eliftplgl/ELE713-Two-Switch-Flyback/Flyback Design Tool.xlsx

 | Flyback Design Tool |  |  |  |  |  |  | COMPANSATOR DESIGN
 |  |  |  |  |  | ETD44 | ETD39
 |  | B_peak (selected) (T) | 0.3 | CORE | Ae (m^2) | 0.000173 | 0.000125 | Rout | 1.2
Given |  | J_rms (A/m^2) | 4000000 |  | g (mm) | 0.5 | 1 | Rcs | 0.004
Calculated |  | fill factor (selected) | 0.3 |  | Al (H/turns^2) | 4.38e-07 | 1.96e-07 | Acs | 3
 |  | fs (Hz) | 100000 |  | Aw (m^2) | 0.00027853 | 0.0002343 | tau_L | 1.572580645
 |  | n (efficiency) | 0.85 |  | Ve (m^3) | 1.78e-05 | 1.15e-05 | M | 0.6666666667
 |  | V_in_max (V) | 72 |  | N1 (calculated) | 9.282715253 | 13.87663127 | (1-Dmax)^2/tau_L | 0.2143920596
 |  | V_in_min (V) | 36 |  | N2 (calculated) | 4.641357627 | 6.938315634 | Go_1 | 200
 |  | V_out (V) | 12 |  | N1 (selected) | 10 | 14 | Go_2 | 0.3925069801
 |  | V_diode (V) | 1 |  | N2 (selected) | 5 | 7 | Go | 78.50139601
 |  | I_out (A) | 10 |  | B_peak (calculated) (T) | 0.2667802785 | 0.2469908088 | Go(dB) | 37.8975476
 |  | V_out + V_diode (V) | 13 |  | B_min (calculated) (T) | 0.1603799454 | 0.1585470317 | Cout(approx) | 0.001
 |  | P_out (W) | 120 |  | B_swing | 0.1064003332 | 0.08844377704 | Resr(approx) | 0.06
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
