eliftplgl/ELE713-Two-Switch-Flyback/componentList.xlsx

Part Number | Description | Quantity | MOQ | Digikey Link | Mouser Link | Türkiye Satıcı Link | Adet | Note/Comment
LM5576MHX/NOPB | Buck IC | 1 | 1 | https://ozdisan.com/entegre-devreler-icler/guc-entegreleri/dc-dc-voltaj-regulatorleri/LM5576MHXNOPB/585271
CL31B822KBCNNNC | Cap: 8.2 nF VDC: 50 V 1206 | 1 | 5 | https://ozdisan.com/pasif-komponentler/kapasitorler/smt-smd-ve-mlcc-kapasitorler/CL31B822KBCNNNC/28720
CL31B104KBCNNNC | Cap: 100 nF VDC: 50 V 1206 | 1 | 25 | https://ozdisan.com/pasif-komponentler/kapasitorler/smt-smd-ve-mlcc-kapasitorler/CL31B104KBCNNNC/5686
CL31C390JBCNNNC | Cap: 39 pF VDC: 50 V 1206 | 1 | 5 | https://ozdisan.com/pasif-komponentler/kapasitorler/smt-smd-ve-mlcc-kapasitorler/CL31C390JBCNNNC/523567
CL31B681KBCNNNC | Cap: 680 pF VDC: 50 V 1206 | 1 | 2 | https://ozdisan.com/pasif-komponentler/kapasitorler/smt-smd-ve-mlcc-kapasitorler/CL31B681KBCNNNC/523478
CC0805KPX7R9BB122 | Cap: 1.2 nF VDC: 50 V 0805 | 1 | 20 | https://ozdisan.com/pasif-komponentler/kapasitorler/smt-smd-ve-mlcc-kapasitorler/CC0805KPX7R9BB122/748786
CL31B223JBCNNNC | Cap: 22 nF VDC: 50 V 1206 | 1 | 5 | https://ozdisan.com/pasif-komponentler/kapasitorler/smt-smd-ve-mlcc-kapasitorler/CL31B223JBCNNNC/523388
1206S4F1021T5E | Res: 1.02 kΩ 1/4 W 1206 | 1 | 100 | https://ozdisan.com/pasif-komponentler/direncler/smt-smd-ve-cip-direncler/1206S4F1021T5E/505049
1206S4F4642T5E | Res: 46.4 kΩ 1/4 W 1206 | 1 | 100 | https://ozdisan.com/pasif-komponentler/direncler/smt-smd-ve-cip-direncler/1206S4F4642T5E/505175
1206S4F8871T5E | Res: 8.87 kΩ 1/4 W 1206 | 1 | 100 | https://ozdisan.com/pasif-komponentler/direncler/smt-smd-ve-cip-direncler/1206S4F8871T5E/505121
1206S4F2052T5E | Res: 20.5 kΩ 1/4 W 1206 | 1 | 100 | https://ozdisan.com/pasif-komponentler/direncler/smt-smd-ve-cip-direncler/1206S4F2052T5E/505145
V35PWM10HM3 | Schottky VRRM: 100 V Io: 35 A | 1 | 1 | https://ozdisan.com/guc-yari-iletkenleri/diyotlar-modul-diyotlar-ve-dogrultucular/schottky-diyotlar/V35PWM10HM3I-/743120
7447709680 | L: 68 µH DCR: 69 mΩ IDC: 3.2 A | 1 | 1 | https://ozdisan.com/pasif-komponentler/induktorler/sabit-induktorler/7447709680/514624
UC3845D8TR | Main Controller | 1 | 1 | https://ozdisan.com/integrated-circuits-ics/power-management-ics/dc-dc-switching-voltage-controllers/UC3845D8TR/445731
CC1206JRNPO9BN101 | Cap: 100 pF VDC: 50 V 1206 | 1 | 5 | https://ozdisan.com/passive-components/capacitors/smt-smd-and-mlcc-capacitors/CC1206JRNPO9BN101/750845
CL31B152KBCNNNC | Cap: 1.5 nF VDC: 50 V 1206 (CT) | 1 | 5 | https://ozdisan.com/passive-components/capacitors/smt-smd-and-mlcc-capacitors/CL31B152KBCNNNC/5693
CC1206KRX7R9BB682 | Cap: 6.8 nF VDC: 50 V 1206 | 1 | 5 | https://ozdisan.com/passive-components/capacitors/smt-smd-and-mlcc-capacitors/CC1206KRX7R9BB682/750181
C1206C103K5RACTU | Cap: 10 nF VDC: 50 V 1206 | 2 | 10 | https://ozdisan.com/passive-components/capacitors/smt-smd-and-mlcc-capacitors/C1206C103K5RACTU/704136
CL31B105KBHNNNE | Cap: 1 uF VDC: 50 V 1206 | 1 | 20 | https://ozdisan.com/passive-components/capacitors/smt-smd-and-mlcc-capacitors/CL31B105KBHNNNE/15253
CL31B475KBHNNNE | Cap: 4.7 uF VDC: 50 V 1206 | 1 | 5 | https://ozdisan.com/passive-components/capacitors/smt-smd-and-mlcc-capacitors/CL31B475KBHNNNE/369460
BVT-I-R004-1.0 | Res: 4 mΩ 6 W 2512 (Shunt) | 1 | 1 | https://ozdisan.com/passive-components/resistors/precision-power-and-shunt-resistors/BVT-I-R004-1-0/536254
1206S4F6800T5E | Res: 680 Ω 1/4 W 1206 1% | 1 | 100 | https://ozdisan.com/passive-components/resistors/smt-smd-and-chip-resistors/1206S4F6800T5E/345241
1206S4F1001T5E | Res: 1 kΩ 1/4 W 1206 1% | 2 | 100 | https://ozdisan.com/passive-components/resistors/smt-smd-and-chip-resistors/1206S4F1001T5E/31106
1206S4F2491T5E | Res: 2.49 kΩ 1/4 W 1206 1% | 1 | 100 | https://ozdisan.com/passive-components/resistors/smt-smd-and-chip-resistors/1206S4F2491T5E/505079
1206S4F4221T5E | Res: 4.22 kΩ 1/4 W 1206 1% (Rcsf) | 1 | 100 | https://ozdisan.com/passive-components/resistors/smt-smd-and-chip-resistors/1206S4F4221T5E/505095
0805S8F4991T5E | Res: 4.99 kΩ 1/8 W 0805 1% | 1 | 100 | https://ozdisan.com/passive-components/resistors/smt-smd-and-chip-resistors/1206S4F2491T5E/505079
1206S4F5761T5E | Res: 5.76 kΩ 1/4 W 1206 1% (RT) | 1 | 100 | https://ozdisan.com/passive-components/resistors/smt-smd-and-chip-resistors/1206S4F5761T5E/505106
2176093-3 | Res: 9.53 kΩ 1/4 W 1206 1% | 1 | 100 | https://ozdisan.com/passive-components/resistors/smt-smd-and-chip-resistors/1206S4F9531T5E/505123
CQ06S4F1002T5E | Res: 10 kΩ 1/4 W 1206 1% | 2 | 100 | https://ozdisan.com/passive-components/resistors/smt-smd-and-chip-resistors/CQ06S4F1002T5E/588060
1206S4F1822T5E | Res: 18.2 kΩ 1/4 W 1206 1% (Rp) | 1 | 100 | https://ozdisan.com/passive-components/resistors/smt-smd-and-chip-resistors/1206S4F1822T5E/505141
1206S4F3902T5E | Res: 39 kΩ 1/4 W 1206 1% | 1 | 100 | https://ozdisan.com/passive-components/resistors/smt-smd-and-chip-resistors/1206S4F3902T5E/35634
0805S8J0115T5E | Res: 1.1 MΩ 1/8 W 0805 5% | 1 | 100 | https://ozdisan.com/passive-components/resistors/smt-smd-and-chip-resistors/0805S8J0115T5E/335350
PZT2907AT1G | PNP | 1 | 2 | https://ozdisan.com/power-semiconductors/transistors/discrete-transistors/PZT2907AT1G/476538
PZT2222AT1G | NPN | 1 | 2 | https://ozdisan.com/power-semiconductors/transistors/discrete-transistors/PZT2222AT1G/476537
ISOM8110DFGR | Optocoupler | 1 |  | https://www.digikey.com/en/products/detail/texas-instruments/ISOM8110DFGR/22119473
BZT585B10T-7 | ZENER 10V 350 mW | 1 | 5 | https://ozdisan.com/power-semiconductors/diodes-diode-modules-and-rectifiers/zener-diodes/BZT585B10T-7/461982
TL431LIBQDBZRQ1 | TL431 | 1 | 1 | https://ozdisan.com/integrated-circuits-ics/power-management-ics/voltage-reference-ics/TL431LIBQDBZRQ1/1044375
R1S-1212-R | Isolated Supply 12-12 | 1 | 1 | https://ozdisan.com/power-supplies/converter-modules/dcdc-converters/R1S-1212-R/539069
DSSK28-006BS-TRL | Secondary Diode | 1 | 1 | https://ozdisan.com/power-semiconductors/diodes-diode-modules-and-rectifiers/schottky-diodes/DSSK28-006BS-TRL/642464
V35PWM10HM3/I | Primary Diodes | 2 | 2 | https://ozdisan.com/power-semiconductors/diodes-diode-modules-and-rectifiers/schottky-diodes/V35PWM10HM3I-/743120
FDD86110 | Primary MOSFETs | 2 | 2 | https://ozdisan.com/power-semiconductors/mosfets/discrete-mosfets/FDD86110/514788
2EDS8265HXUMA1 | Gate Driver | 1 | 1 | https://ozdisan.com/entegre-devreler-icler/guc-entegreleri/guc-surucu-entegreleri/2EDS8265HXUMA1/650229
BZX384-B15,115 | ZENER 15V 300 mW | 2 | 2 | https://ozdisan.com/guc-yari-iletkenleri/diyotlar-modul-diyotlar-ve-dogrultucular/zener-diyotlar/BZX384-B15115/538378
HP122WF100JT4E | Res: 10 Ω 2 W 2512 1% (Gate) | 2 | 5 | https://ozdisan.com/pasif-komponentler/direncler/smt-smd-ve-cip-direncler/HP122WF100JT4E/604578
HP06W2F1003T5E | Res: 100 kΩ 1/2 W 1206 1% | 2 | 50 | https://ozdisan.com/pasif-komponentler/direncler/smt-smd-ve-cip-direncler/HP06W2F1003T5E/604439
A768KS227M1VLAE024 | Cap Al: 47uF VDC: 50 V (1 mains_out, 1 buck_out) | 2 | 2 | https://ozdisan.com/pasif-komponentler/kapasitorler/aluminyum-kapasitorler/EEE-FT1H470AP/1044577
CL32B106KBJNNWE | Cap: 10 µF VDC: 50 V 1210 (2 iso_in, 3 gate driver, 2 buck_out, 3 mains_out) | 10 | 10 | https://ozdisan.com/pasif-komponentler/kapasitorler/smt-smd-ve-mlcc-kapasitorler/CL32B106KBJNNWE/523679
CL32B225KCJSNNE | Cap: 2.2 µF VDC: 100 V 1210 (3 buck_in, 3 mains_in) | 6 | 6 | https://ozdisan.com/pasif-komponentler/kapasitorler/smt-smd-ve-mlcc-kapasitorler/CL32B225KCJSNNE/483445
R82EC4100DQ70J | Cap Film: 1uF VDC: 100 V (2 mains_in, 2_mains_out) | 4 | 4 | https://ozdisan.com/pasif-komponentler/kapasitorler/film-kapasitorler/R82EC4100DQ70J/27926
