eliftplgl/ELE713-Two-Switch-Flyback/componentList_digikey.xlsx

Part Number | Description | Quantity | Digikey Link | Mouser Link | Türkiye Satıcı Link | Adet | Note/Comment
C0805C470J5GAC7800 | Cap: 47 pF VDC: 50 V 0805 | 1 | https://www.digikey.com/en/products/detail/kemet/C0805C470J5GAC7800/411116
CPF-A-0805B1M0E | Res: 1 MΩ 1/8 W 0805 0.1% | 1 | https://www.digikey.com/en/products/detail/te-connectivity-passive-product/CPF-A-0805B1M0E/5583876
C0805C222K5RACTU | Cap: 2.2 nF VDC: 50 V 0805 | 1 | https://www.digikey.com/en/products/detail/kemet/C0805C222K5RACTU/411150
CPF0805B100KE | Res: 100 kΩ 1/8 W 0805 0.1% | 1 | https://www.digikey.com/en/products/detail/te-connectivity-passive-product/CPF0805B100KE/2389788
LM5012DDAR | Buck IC | 1 | https://www.digikey.com/en/products/detail/texas-instruments/LM5012DDAR/16893898
CL32Y226KAVVPNE | Cap: 22 µF VDC: 25 V 1210 (DC-link) | 2 | https://www.digikey.com/en/products/detail/samsung-electro-mechanics/CL32Y226KAVVPNE/14565402
CL32Y475KCIVPJE | Cap: 4.7 µF VDC: 100 V 1210 (DC-link) | 4 | https://www.digikey.com/en/products/detail/samsung-electro-mechanics/CL32Y475KCIVPJE/14565405
7447709680 | L: 68 µH, 3.2 A R: 89mOhm | 1 | https://www.digikey.com/en/products/detail/würth-elektronik/7447709680/1638652
SDT5H100LP5-7 | Schottky VRRM: 100 V, Io = 5A | 1 | https://www.digikey.com/en/products/detail/diodes-incorporated/SDT5H100LP5-7/6702172
C0805C222K5RACTU | Cap: 2.2 nF VDC: 50 V 0805 | 1 | https://www.digikey.com/en/products/detail/kemet/C0805C222K5RACTU/411150
5-2176094-6 | Res: 453 kΩ 1/8 W 0805 0.1% | 1 | https://www.digikey.com/en/products/detail/te-connectivity-passive-product/5-2176094-6/4034266
RN73C2A49K9BTDF | Res: 49.9 kΩ 1/10 W 0805 0.1% | 1 | https://www.digikey.com/en/products/detail/te-connectivity-passive-product/RN73C2A49K9BTDF/2055754
CPF-A-0805B1M0E | Res: 1 MΩ 1/8 W 0805 0.1% | 1 | https://www.digikey.com/en/products/detail/te-connectivity-passive-product/CPF-A-0805B1M0E/5583876
750315126 | Flyback Transformer | 1 | https://www.digikey.com/en/products/detail/würth-elektronik/750315126/6173514
PMEG6030EP,115 | Schottky VRRM: 60 V, Io = 3A | 1 | https://www.digikey.com/en/products/detail/nexperia-usa-inc/PMEG6030EP-115/2296186
DFLS1150-7 | Schottky VRRM: 150 V, Io = 1A | 1 | https://www.digikey.com/en/products/detail/diodes-incorporated/DFLS1150-7/765613
CMZ5944B TR13 PBFREE | ZENER 62 V 1.5 W | 1 | https://www.digikey.com/en/products/detail/central-semiconductor-corp/CMZ5944B-TR13-PBFREE/5325075
CL32Y106KCVZNWE | Cap: 10 µF VDC: 100 V 1210 (DC-link) | 2 | https://www.digikey.com/en/products/detail/samsung-electro-mechanics/CL32Y106KCVZNWE/15992073
CL32Y226KAVVPNE | Cap: 22 µF VDC: 25 V 1210 (DC-link) | 3 | https://www.digikey.com/en/products/detail/samsung-electro-mechanics/CL32Y226KAVVPNE/14565402
CL32Y475KCIVPJE | Cap: 4.7 µF VDC: 100 V 1210 (DC-link) | 3 | https://www.digikey.com/en/products/detail/samsung-electro-mechanics/CL32Y475KCIVPJE/14565405
9-2176093-0 | Res: 88.7 kΩ 1/8 W 0805 0.1% | 1 | https://www.digikey.com/en/products/detail/te-connectivity-passive-product/9-2176093-0/4034198
CPF0805B10KE | Res: 10 kΩ 1/8 W 0805 0.1% | 1 | https://www.digikey.com/en/products/detail/te-connectivity-passive-product/CPF0805B10KE/2389790
2-2176094-9 | Res: 237 kΩ 1/8 W 0805 0.1% | 1 | https://www.digikey.com/en/products/detail/te-connectivity-passive-product/2-2176094-9/4034239
3522100RJT | Res: 100 Ω 3 W 2512 (Snubber) | 1 | https://www.digikey.com/en/products/detail/te-connectivity-passive-product/3522100RJT/5244970
R76QD0220SE00J | Cap: 220 pF 1 kV (Snubber) | 1 | https://www.digikey.com/en/products/detail/kemet/R76QD0220SE00J/2704673
LT8304IS8E#PBF | Flyback Controller | 1 | https://www.digikey.com/en/products/detail/analog-devices-inc/LT8304IS8E-PBF/6025915
CL21A475KAQNNNE | Cap: 4.7 uF VDC: 25 V 0805 | 1 | https://www.digikey.com/en/products/detail/samsung-electro-mechanics/CL21A475KAQNNNE/3886902
CPF0805B10KE | Res: 10 kΩ 1/8 W 0805 0.1% | 2 | https://www.digikey.com/en/products/detail/te-connectivity-passive-product/CPF0805B10KE/2389790
PMBT2907A-QR | PNP | 1 | https://www.digikey.com/en/products/detail/nexperia-usa-inc/PMBT2907A-QR/18634502
PMBT2222A-QR | NPN | 1 | https://www.digikey.com/en/products/detail/nexperia-usa-inc/PMBT2222A-QR/18634518
C0805C682K5RAC7800 | Cap: 6.8 nF VDC: 50 V 0805 | 1 | https://www.digikey.com/en/products/detail/kemet/C0805C682K5RAC7800/411156
C0805C103K5RACTU | Cap: 10 nF VDC: 50 V 0805 | 2 | https://www.digikey.com/en/products/detail/kemet/C0805C103K5RACTU/411157
CPF0805B1M1E1 | Res: 1.1 MΩ 1/10 W 0805 0.1% | 1 | https://www.digikey.com/en/products/detail/te-connectivity-passive-product/CPF0805B1M1E1/2731308
CPF-A-0805B12KE | Res: 12 kΩ 1/10 W 0805 0.1% | 1 | https://www.digikey.com/en/products/detail/te-connectivity-passive-product/CPF-A-0805B12KE/5583862
C0805C471K5RAC7800 | Cap: 470 pF VDC: 50 V 0805 | 1 | https://www.digikey.com/en/products/detail/kemet/C0805C471K5RAC7800/411141
C0805C101J5GAC7800 | Cap: 100 pF VDC: 50 V 0805 | 1 | https://www.digikey.com/en/products/detail/kemet/C0805C101J5GAC7800/411121
C0805C105K3RAC7210 | Cap: 1 uF VDC: 25 V 0805 | 1 | https://www.digikey.com/en/products/detail/kemet/C0805C105K3RAC7210/12701357
6-2176092-8 | Res: 3.83 kΩ 1/4 W 0805 0.1% | 1 | https://www.digikey.com/en/products/detail/te-connectivity-passive-product/6-2176092-8/4034067
2-2176093-4 | Res: 16.5 kΩ 1/4 W 0805 0.1% | 1 | https://www.digikey.com/en/products/detail/te-connectivity-passive-product/2-2176093-4/4034128
CPF0805B4K99E1 | Res: 4.99 kΩ 1/10 W 0805 0.1% | 1 | https://www.digikey.com/en/products/detail/te-connectivity-passive-product/CPF0805B4K99E1/2383373
CPF0805B1K0E | Res: 1 kΩ 1/10 W 0805 0.1% | 2 | https://www.digikey.com/en/products/detail/te-connectivity-passive-product/CPF0805B1K0E/2390399
CPF-A-0805B680RE | Res: 680 Ω 1/10 W 0805 0.1% | 1 | https://www.digikey.com/en/products/detail/te-connectivity-passive-product/CPF-A-0805B680RE/5583918
CPF-A-0805B39KE | Res: 39 kΩ 1/10 W 0805 0.1% | 1 | https://www.digikey.com/en/products/detail/te-connectivity-passive-product/CPF-A-0805B39KE/5583901
2176093-3 | Res: 9.53 kΩ 1/10 W 0805 0.1% | 1 | https://www.digikey.com/en/products/detail/te-connectivity-passive-product/2176093-3/4034105
5-2176092-1 | Res: 2.49 kΩ 1/10 W 0805 0.1% | 1 | https://www.digikey.com/en/products/detail/te-connectivity-passive-product/5-2176092-1/4034049
BZX84-A10,215 | ZENER 10V 250 mW | 1 | https://www.digikey.com/en/products/detail/nexperia-usa-inc/BZX84-A10-215/2119643
TL431LIBQDBZR | TL431 | 1 | https://www.digikey.com/en/products/detail/texas-instruments/TL431LIBQDBZR/9861503
UCC28C55DGKR | Main Controller | 1 | https://www.digikey.com/en/products/detail/texas-instruments/UCC28C55DGKR/18111331
TLRP3A30CR004FTE | Res: 4 mΩ 3 W 2512 (Shunt) | 1 | https://www.digikey.com/en/products/detail/te-connectivity-passive-product/TLRP3A30CR004FTE/14652341
ISOM8110DFGR | Optocoupler | 1 | https://www.digikey.com/en/products/detail/texas-instruments/ISOM8110DFGR/22119473
V35PWL63-M3/I | Secondary Diode | 1 | https://www.digikey.com/en/products/detail/vishay-general-semiconductor-diodes-division/V35PWL63-M3-I/16683171
SDT5H100LP5-7 | Primary Diodes | 2 | https://www.digikey.com/en/products/detail/diodes-incorporated/SDT5H100LP5-7/6702172
BSC096N10LS5ATMA1 | Primary MOSFETs | 2 | https://www.digikey.com/en/products/detail/infineon-technologies/BSC096N10LS5ATMA1/11500405
2EDB8259FXUMA1 | Gate Driver | 1 | https://www.digikey.com/en/products/detail/infineon-technologies/2EDB8259FXUMA1/16669035
BZT52H-A18-QX | ZENER 18V 250 mW | 2 | https://www.digikey.com/en/products/detail/nexperia-usa-inc/BZT52H-A18-QX/17295694
RQ73C2B10RBTD | Res: 10 Ω 1 W 1206 0.1% | 2 | https://www.digikey.com/en/products/detail/te-connectivity-passive-product/RQ73C2B10RBTD/9479828
CPF0805B100KE | Res: 100 kΩ 1/8 W 0805 0.1% | 2 | https://www.digikey.com/en/products/detail/te-connectivity-passive-product/CPF0805B100KE/2389788
SC-18-10J | Input Choke | 2 | https://www.digikey.com/en/products/detail/kemet/SC-18-10J/10441828
A759MS226M2AAAE045 | Input AlPo Cap | 2 | https://www.digikey.com/en/products/detail/kemet/A759MS226M2AAAE045/6196528
R60IN43305030J | Input Film Cap | 2 | https://www.digikey.com/en/products/detail/kemet/R60IN43305030J/12178362
CL32Y475KCIVPJE | Cap: 4.7 µF VDC: 100 V 1210 (DC-link) | 4 | https://www.digikey.com/en/products/detail/samsung-electro-mechanics/CL32Y475KCIVPJE/14565405
A768KS227M1VLAE024 | Output AlPo Cap | 2 | https://www.digikey.com/en/products/detail/kemet/A768KS227M1VLAE024/12704040
R66DD4220AA6AJ | Output Film Cap | 2 | https://www.digikey.com/en/products/detail/kemet/R66DD4220AA6AJ/13176308
CL32Y226KAVVPNE | Cap: 22 µF VDC: 25 V 1210 (DC-link) | 4 | https://www.digikey.com/en/products/detail/samsung-electro-mechanics/CL32Y226KAVVPNE/14565402
