eliftplgl/ELE713-Two-Switch-Flyback/PCB/ele713_ozdisan/ele713_ozdisan/KiCad Library/LM5576MHX_NOPB.step

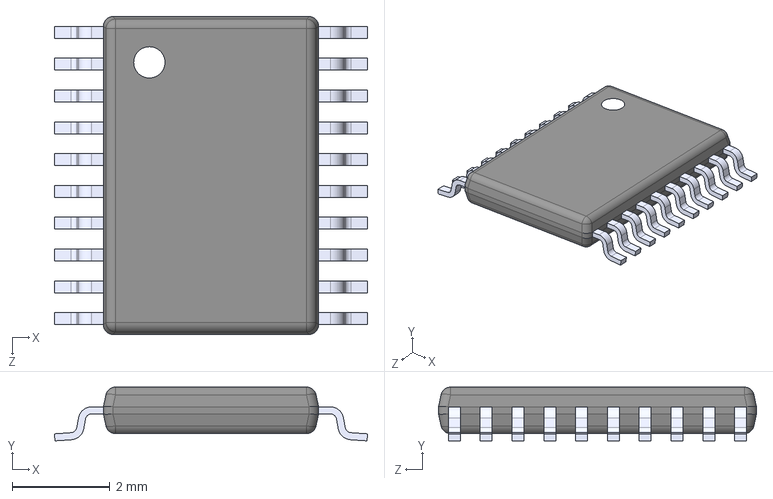
[picture p11: CAD file, 2024-12-31]
PCB/ele713_ozdisan/ele713_ozdisan/KiCad Library/LM5576MHX_NOPB.step
6.40 x 1.10 x 6.50 mm
