eliftplgl/ELE713-Two-Switch-Flyback/PCB/ele713_ozdisan/ele713_ozdisan/KiCad Library/UC3845AD8G4.step

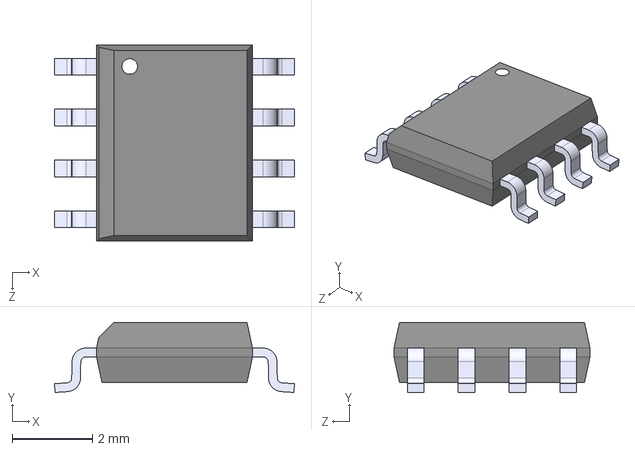
[picture p12: CAD file, 2024-12-31]
PCB/ele713_ozdisan/ele713_ozdisan/KiCad Library/UC3845AD8G4.step
6.00 x 1.75 x 4.90 mm
