eliftplgl/ELE713-Two-Switch-Flyback/PCB/ele713_ozdisan/ele713_ozdisan/KiCad Library/R1S-1212-R.step

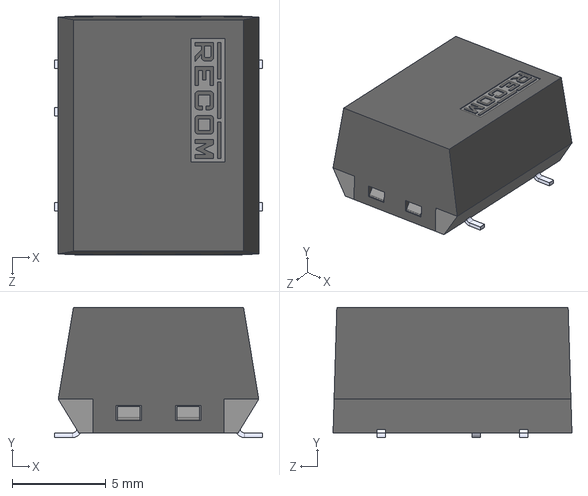
[picture p13: CAD file, 2024-12-31]
PCB/ele713_ozdisan/ele713_ozdisan/KiCad Library/R1S-1212-R.step
11.1 x 6.95 x 12.8 mm
