eliftplgl/ELE713-Two-Switch-Flyback/PCB/ele713_ozdisan/ele713_ozdisan/KiCad Library/WE-PD_1210.step

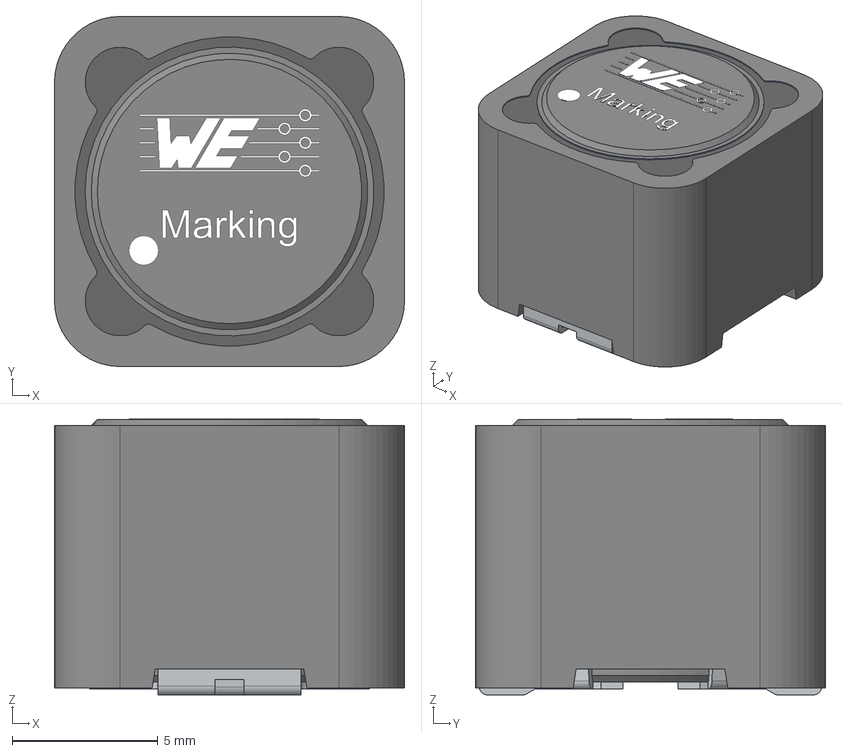
[picture p14: CAD file, 2024-12-31]
PCB/ele713_ozdisan/ele713_ozdisan/KiCad Library/WE-PD_1210.step
12.0 x 12.0 x 9.46 mm
Core
ShieldRing
Glue
Leadframe
