eliftplgl/ELE713-Two-Switch-Flyback/PCB/ele713_ozdisan/ele713_ozdisan/KiCad Library/R82EC4100DQ70J.stp

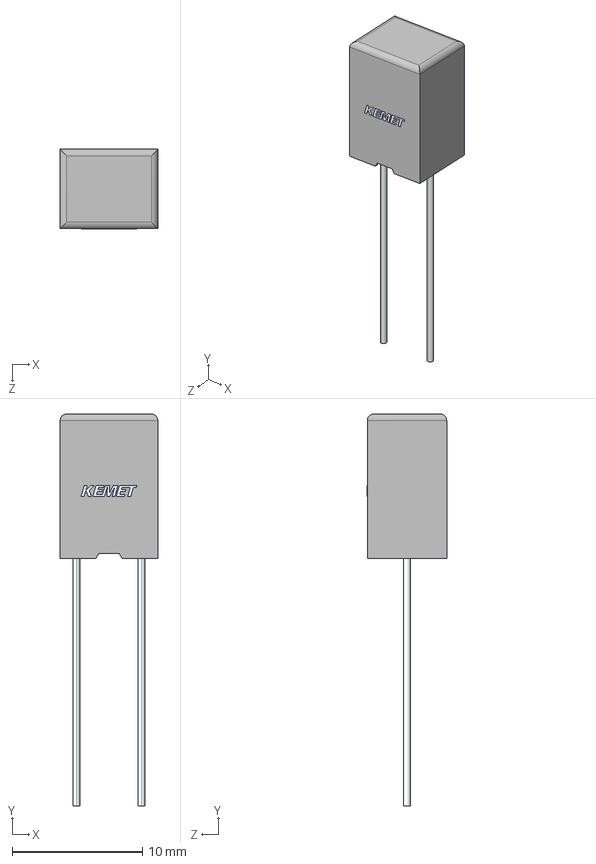
[picture p15: CAD file, 2024-12-31]
PCB/ele713_ozdisan/ele713_ozdisan/KiCad Library/R82EC4100DQ70J.stp
7.50 x 30.1 x 6.10 mm
