eliftplgl/ELE713-Two-Switch-Flyback/PCB/ele713_ozdisan/ele713_ozdisan/KiCad Library/BZT585B10T-7.stp

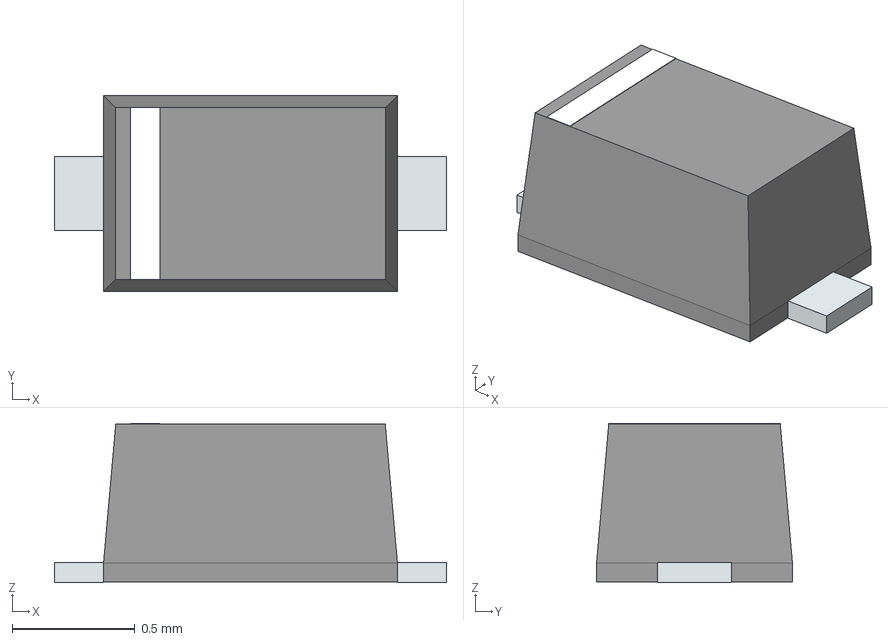
[picture p16: CAD file, 2024-12-31]
PCB/ele713_ozdisan/ele713_ozdisan/KiCad Library/BZT585B10T-7.stp
1.60 x 0.8 x 0.65 mm
PinKIdent
PinK
PinA
