eliftplgl/ELE713-Two-Switch-Flyback/PCB/ele713_ozdisan/ele713_ozdisan/KiCad Library/R76QD0220SE00J.stp

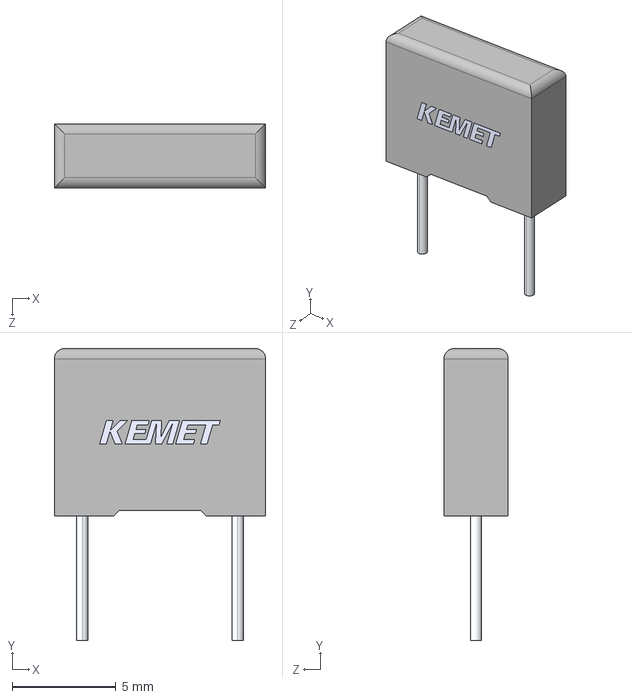
[picture p17: CAD file, 2024-12-11]
PCB/ele713_ozdisan/ele713_ozdisan/KiCad Library/R76QD0220SE00J.stp
10.2 x 14.1 x 3.10 mm
