eliftplgl/ELE713-Two-Switch-Flyback/PCB/ele713_ozdisan/ele713_ozdisan/KiCad Library/PowerDI5.stp

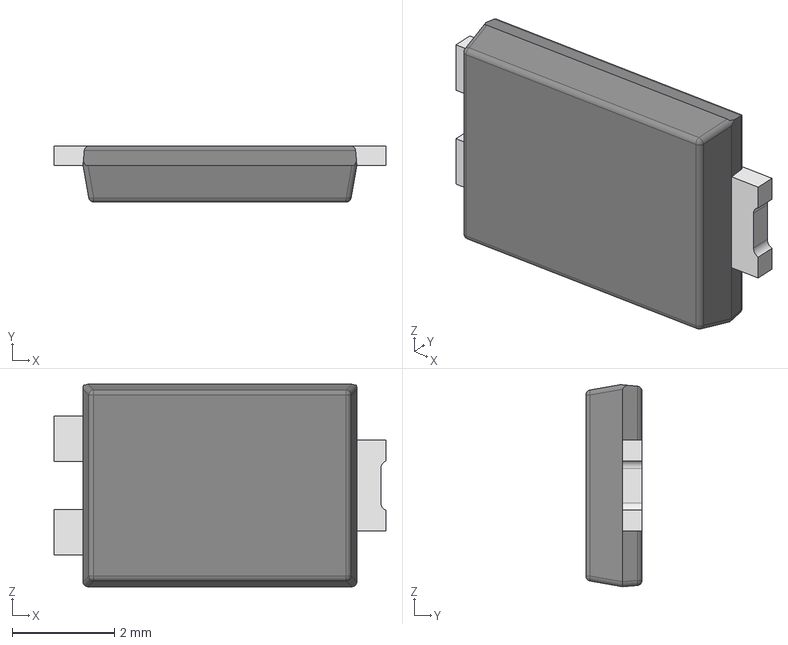
[picture p18: CAD file, 2024-12-11]
PCB/ele713_ozdisan/ele713_ozdisan/KiCad Library/PowerDI5.stp
6.51 x 1.10 x 3.97 mm
PD-5 compound
PD-5 LF_0
PD-5 LF
