eliftplgl/ELE713-Two-Switch-Flyback/PCB/ele713_ozdisan/ele713_ozdisan/KiCad Library/A768KS227M1VLAE024.stp

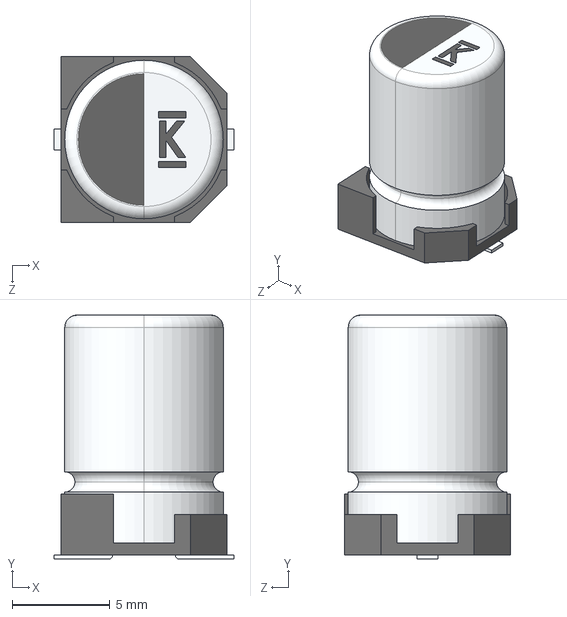
[picture p19: CAD file, 2024-12-11]
PCB/ele713_ozdisan/ele713_ozdisan/KiCad Library/A768KS227M1VLAE024.stp
9.20 x 12.5 x 8.50 mm
