eliftplgl/ELE713-Two-Switch-Flyback/PCB/ele713_ozdisan/ele713_ozdisan/KiCad Library/WE-FLYLT_EP13_L13.46W17.75H12.70.STEP

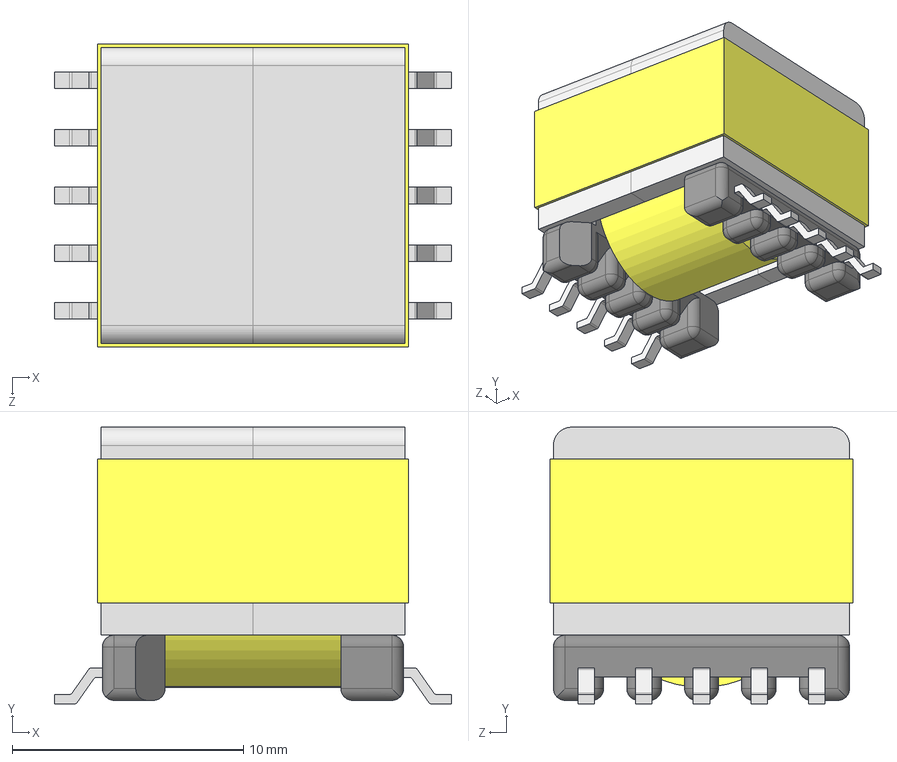
[picture p20: CAD file, 2024-12-11]
PCB/ele713_ozdisan/ele713_ozdisan/KiCad Library/WE-FLYLT_EP13_L13.46W17.75H12.70.STEP
17.2 x 12.0 x 13.1 mm
070-5465_6A
070-5465_coil
150-2363_6A x 2
