eliftplgl/ELE713-Two-Switch-Flyback/PCB/ele713_ozdisan/ele713_ozdisan/KiCad Library/F861KM473M310A.stp

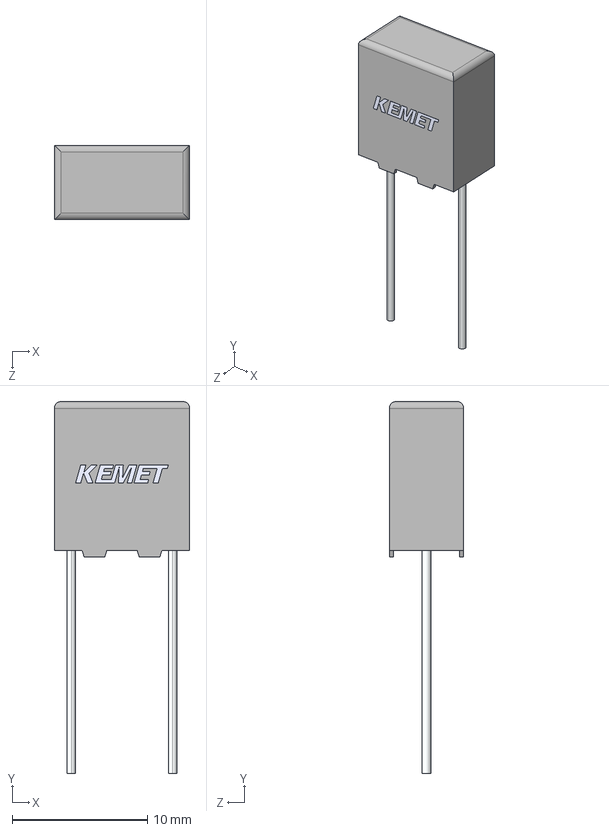
[picture p21: CAD file, 2024-12-11]
PCB/ele713_ozdisan/ele713_ozdisan/KiCad Library/F861KM473M310A.stp
10.0 x 27.5 x 5.50 mm
