eliftplgl/ELE713-Two-Switch-Flyback/PCB/ele713_ozdisan/ele713_ozdisan/KiCad Library/R46KN410050N1K.stp

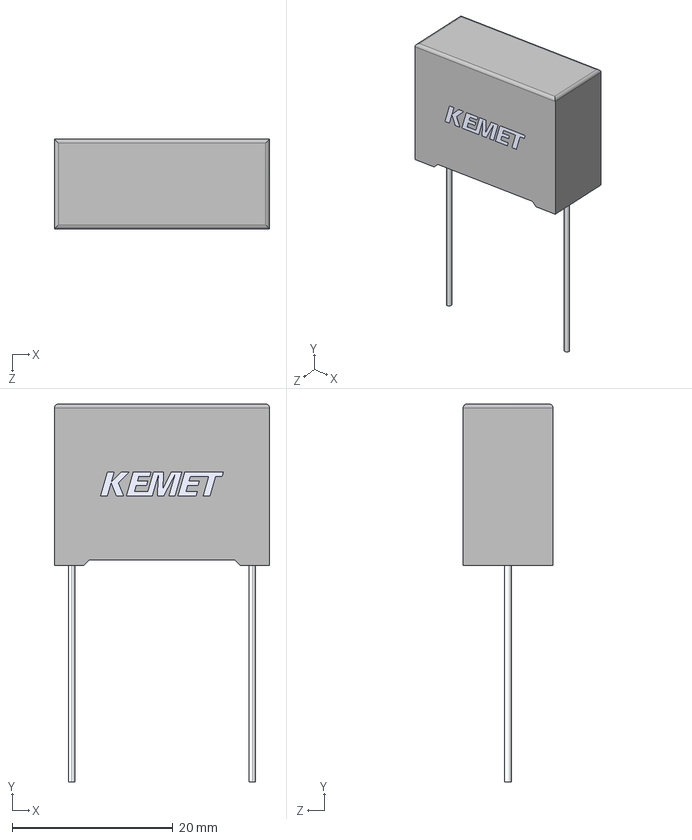
[picture p22: CAD file, 2024-12-11]
PCB/ele713_ozdisan/ele713_ozdisan/KiCad Library/R46KN410050N1K.stp
26.8 x 47.1 x 11.2 mm
