eliftplgl/ELE713-Two-Switch-Flyback/PCB/ele713_ozdisan/ele713_ozdisan/KiCad Library/DFG0004A.stp

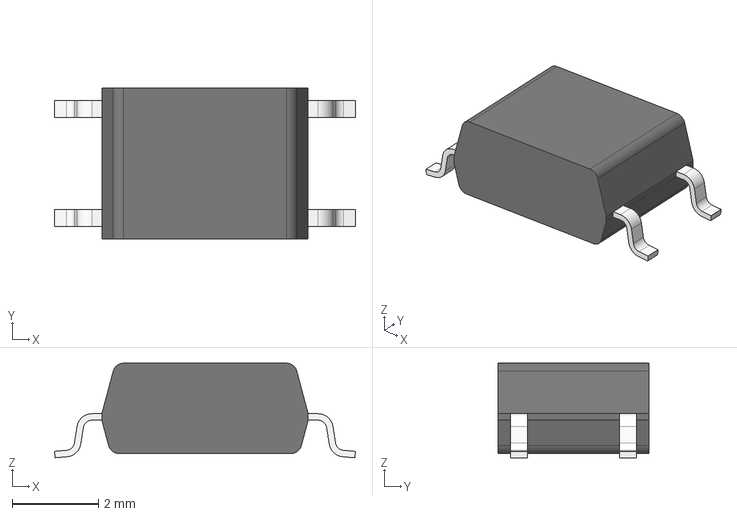
[picture p23: CAD file, 2024-12-11]
PCB/ele713_ozdisan/ele713_ozdisan/KiCad Library/DFG0004A.stp
7.00 x 3.51 x 2.20 mm
DFG0004A_MOLD
DFG0004A_PIN x 4
