eliftplgl/ELE713-Two-Switch-Flyback/PCB/ele713_ozdisan/ele713_ozdisan/KiCad Library/SC-18-10J.stp

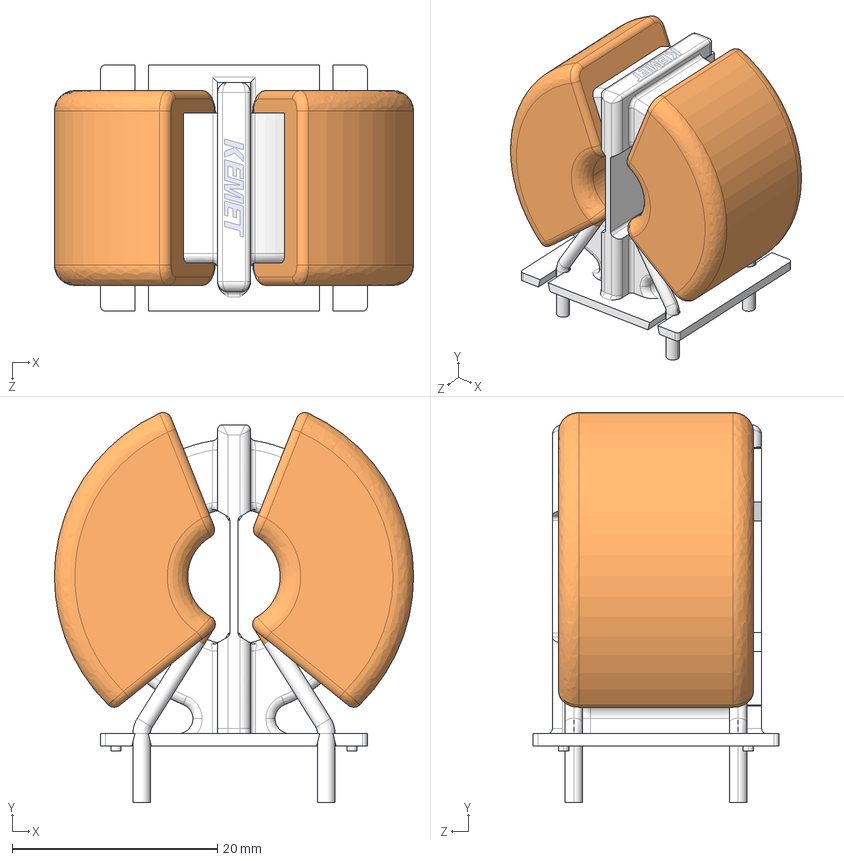
[picture p24: CAD file, 2024-12-11]
PCB/ele713_ozdisan/ele713_ozdisan/KiCad Library/SC-18-10J.stp
35.0 x 38.0 x 24.0 mm
