eliftplgl/ELE713-Two-Switch-Flyback/PCB/ele713_ozdisan/ele713_ozdisan/KiCad Library/c61036-a0104-b201_etd39_sw.step

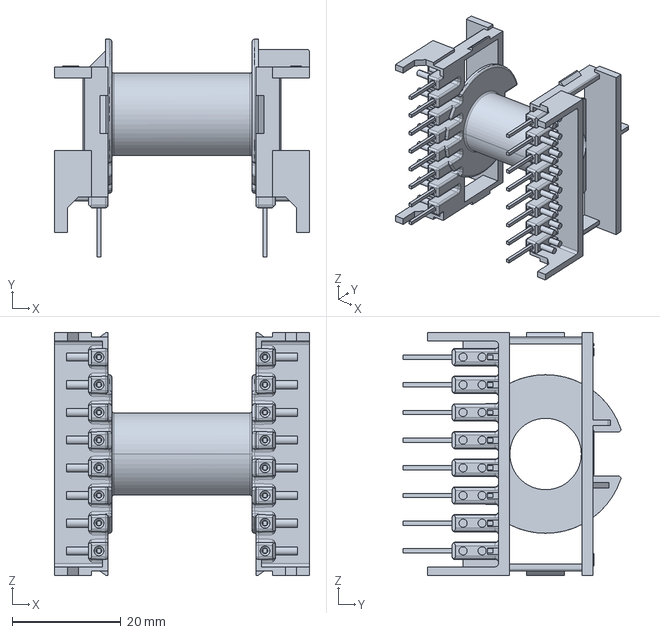
[picture p25: CAD file, 2024-12-11]
PCB/ele713_ozdisan/ele713_ozdisan/KiCad Library/c61036-a0104-b201_etd39_sw.step
46.8 x 40.0 x 44.6 mm
