eliftplgl/ELE713-Two-Switch-Flyback/ltspice flyback sim/Draft1.asc

Cout: cap; 100µ
D1: schottky; RBQ30NS100A
D2: schottky; RBQ30NS100A
D3: schottky; RBQ30NS100A
L1: ind2; 37.7e-6
L2: ind2; 9.43548E-06
M1: nmos; BSC100N10NSF
M2: nmos; BSC100N10NSF
Rload: res; 1.2
V1: voltage; PULSE(-20 10 0 1e-9 1e-9 0.42e-5 1e-5)
V2: voltage; PULSE(-20 10 0 1e-9 1e-9 0.42e-5 1e-5)
Vin: voltage; 36
Named nets: 0, PWM, PWM_high, PWM_low
.tran 1.5e-3
K L1 L2 1
