eliftplgl/ELE713-Two-Switch-Flyback/PCB/ele713_ozdisan/ele713_ozdisan/ele713_ozdisan.kicad_pcb

## KiCad design PCB/ele713_ozdisan/ele713_ozdisan/ele713_ozdisan.kicad_pcb (2024-12-31, an earlier design)

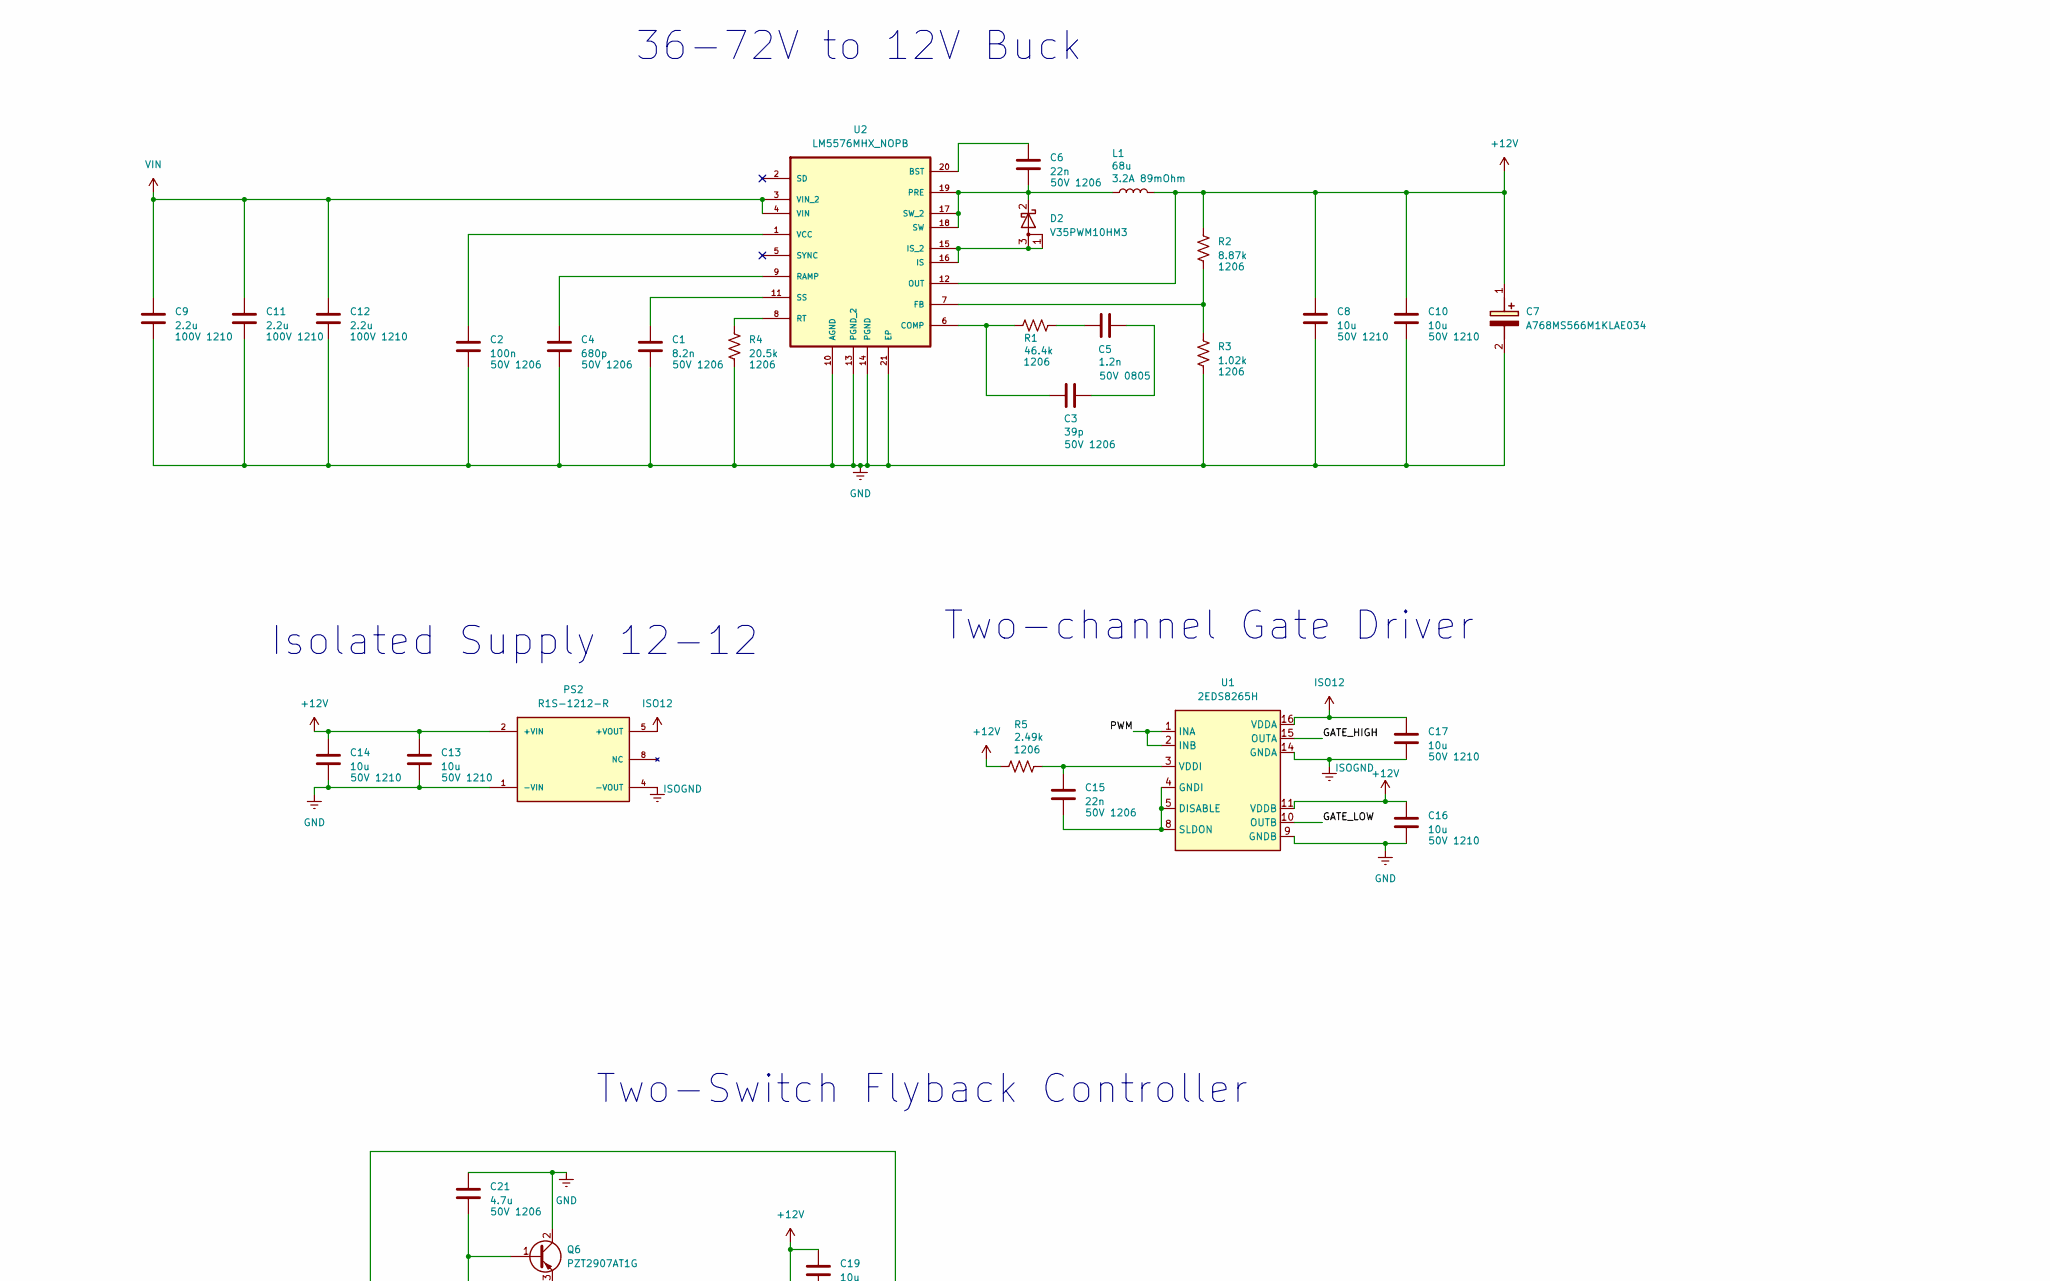
[picture p26: schematic ele713_ozdisan.kicad_sch, part in row 1, column 1]

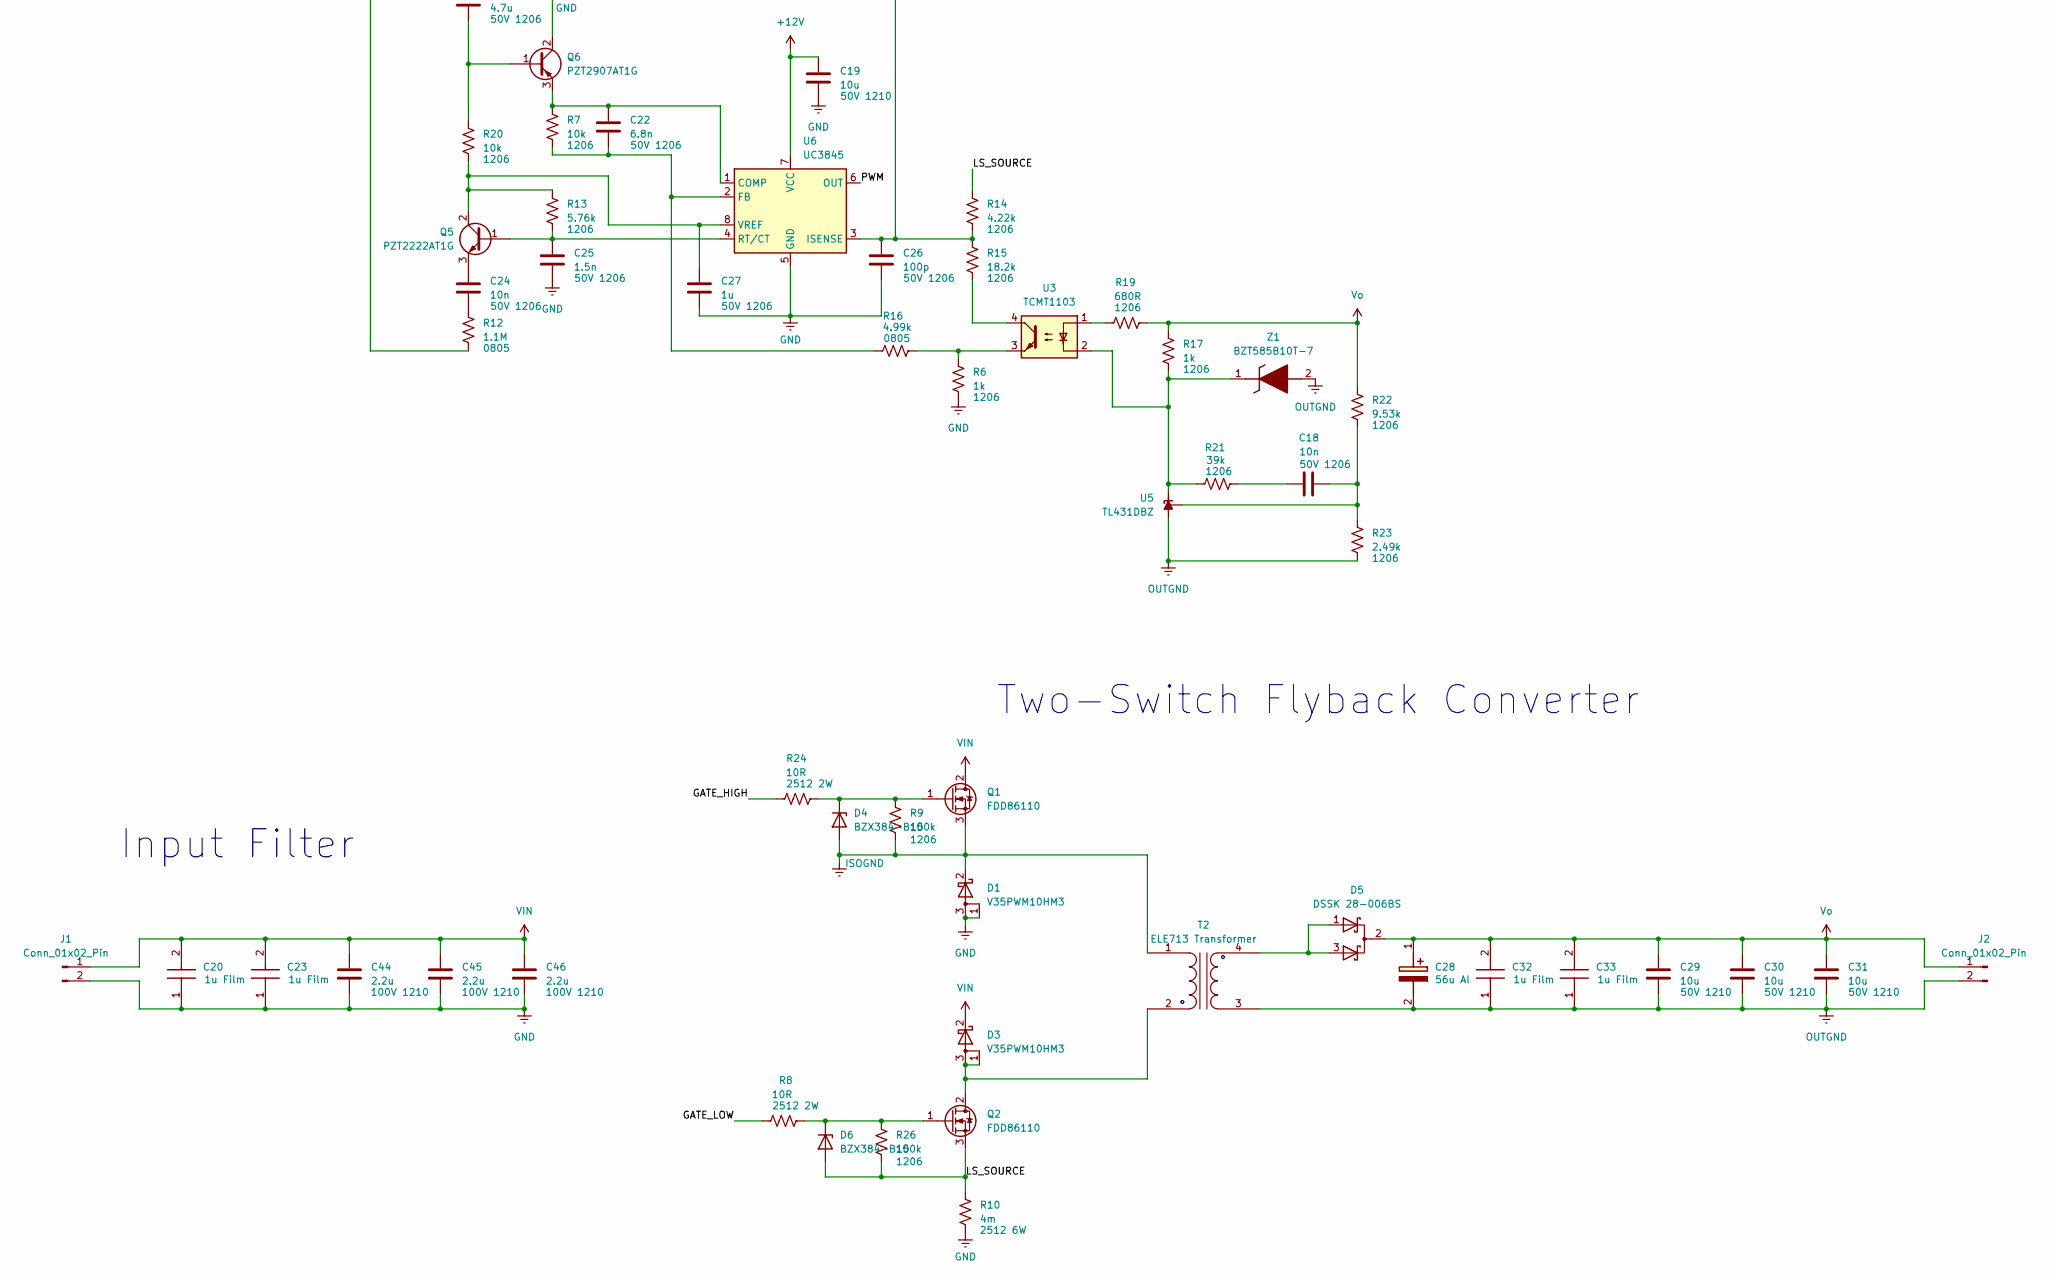
[picture p27: schematic ele713_ozdisan.kicad_sch, part in row 2, column 1]

Parts:
C1: 8.2n; C_1206_3216Metric_Pad1.33x1.80mm_HandSolder
C2: 100n; C_1206_3216Metric_Pad1.33x1.80mm_HandSolder
C3: 39p; C_1206_3216Metric_Pad1.33x1.80mm_HandSolder
C4: 680p; C_1206_3216Metric_Pad1.33x1.80mm_HandSolder
C5: 1.2n; C_0805_2012Metric_Pad1.18x1.45mm_HandSolder
C6, C15: 22n; C_1206_3216Metric_Pad1.33x1.80mm_HandSolder
C7, C28: A768MS566M1KLAE034; CAPAE1030X1270N; Manufacturer_Part_Number A768MS566M1KLAE034; Mouser Part Number 80-A768MS566M1KLAE34
C8, C10, C13, C14, C16, C17, C19, C29, C30, C31: 10u; C_1210_3225Metric_Pad1.33x2.70mm_HandSolder
C9, C11, C12, C44, C45, C46: 2.2u; C_1210_3225Metric_Pad1.33x2.70mm_HandSolder
C18, C24: 10n; C_1206_3216Metric_Pad1.33x1.80mm_HandSolder
C20, C23, C32, C33: R82EC4100DQ70J; Manufacturer_Part_Number R82EC4100DQ70J; Mouser Part Number 80-R82EC4100DQ70J
C21: 4.7u; C_1206_3216Metric_Pad1.33x1.80mm_HandSolder
C22: 6.8n; C_1206_3216Metric_Pad1.33x1.80mm_HandSolder
C25: 1.5n; C_1206_3216Metric_Pad1.33x1.80mm_HandSolder
C26: 100p; C_1206_3216Metric_Pad1.33x1.80mm_HandSolder
C27: 1u; C_1206_3216Metric_Pad1.33x1.80mm_HandSolder
D1, D2, D3: V35PWM10HM3; TO-252-2
D4, D6: BZX384-B15; D_SOD-323_HandSoldering
D5: DSSK 28-006BS; TO-263-2
J1, J2: Conn_01x02_Pin; TerminalBlock_Phoenix_MKDS-1,5-2_1x02_P5.00mm_Horizontal
L1: 68u; WE-PD_1210
PS2: R1S-1212-R; CONV_R1S-1212-R; PARTREV 1; DigiKey_Part_Number 945-1017-2-ND
Q1, Q2: FDD86110; TO-252-2
Q5: PZT2222AT1G; SOT-223-3_TabPin2
Q6: PZT2907AT1G; SOT-223-3_TabPin2
R1: 46.4k; R_1206_3216Metric_Pad1.30x1.75mm_HandSolder
R2: 8.87k; R_1206_3216Metric_Pad1.30x1.75mm_HandSolder
R3: 1.02k; R_1206_3216Metric_Pad1.30x1.75mm_HandSolder
R4: 20.5k; R_1206_3216Metric_Pad1.30x1.75mm_HandSolder
R5, R23: 2.49k; R_1206_3216Metric_Pad1.30x1.75mm_HandSolder
R6, R17: 1k; R_1206_3216Metric_Pad1.30x1.75mm_HandSolder
R7, R20: 10k; R_1206_3216Metric_Pad1.30x1.75mm_HandSolder
R8, R24: 10R; D_2512_6332Metric_Pad1.52x3.35mm_HandSolder
R9, R26: 100k; R_1206_3216Metric_Pad1.30x1.75mm_HandSolder
R10: 4m; R_2512_6332Metric_Pad1.40x3.35mm_HandSolder
R12: 1.1M; R_0805_2012Metric_Pad1.20x1.40mm_HandSolder
R13: 5.76k; R_1206_3216Metric_Pad1.30x1.75mm_HandSolder
R14: 4.22k; R_1206_3216Metric_Pad1.30x1.75mm_HandSolder
R15: 18.2k; R_1206_3216Metric_Pad1.30x1.75mm_HandSolder
R16: 4.99k; R_0805_2012Metric_Pad1.20x1.40mm_HandSolder
R19: 680R; R_1206_3216Metric_Pad1.30x1.75mm_HandSolder
R21: 39k; R_1206_3216Metric_Pad1.30x1.75mm_HandSolder
R22: 9.53k; R_1206_3216Metric_Pad1.30x1.75mm_HandSolder
T2: ELE713 Transformer; ETD39_coilformer
U1: 2EDS8265H; SOIC-16_3.9x9.9mm_P1.27mm
U2: LM5576MHX_NOPB; SOP65P640X110-21N; MPN LM5576MHX/NOPB
U3: TCMT1103; SOP-4_4.4x2.6mm_P1.27mm
U5: TL431DBZ; SOT-23_Handsoldering
U6: UC3845; SOIC127P599X175-8N
Z1: BZT585B10T-7; SODFL1608X65N; Manufacturer_Part_Number BZT585B10T-7; Mouser Part Number 621-BZT585B10T-7

Connections:
+12V: C7.1 (+), C8.1, C10.1, C13.1, C14.1, C16.1, C19.1, L1.2, PS2.2 (+VIN), R2.1, R5.1, U1.11 (VDDB), U2.12 (OUT), U6.7 (VCC)
/GATE_HIGH: R24.1, U1.15 (OUTA)
/GATE_LOW: R8.1, U1.10 (OUTB)
/LS_SOURCE: D6.2 (A), Q2.3 (S), R10.1, R14.1, R26.2
/PWM: U1.1 (INA), U1.2 (INB), U6.6 (OUT)
GND: C1.2, C2.2, C4.2, C7.2 (-), C8.2, C9.2, C10.2, C11.2, C12.2, C13.2, C14.2, C16.2, C19.2, C20.1, C21.1, C23.1, C25.2, C26.2, C27.2, C44.2, C45.2, C46.2, D1.1 (A), D1.3 (A), J1.2, PS2.1 (-VIN), Q6.2 (C), R3.2, R4.2, R6.2, R10.2, U1.9 (GNDB), U2.10 (AGND), U2.13 (PGND_2), U2.14 (PGND), U2.21 (EP), U6.5 (GND)
ISO12: C17.1, PS2.5 (+VOUT), U1.16 (VDDA)
ISOGND: C17.2, D1.2 (K), D4.2 (A), PS2.4 (-VOUT), Q1.3 (S), R9.2, T2.1 (AA), U1.14 (GNDA)
unnamed: C3.2, C5.2
unnamed: C5.1, R1.2
unnamed: C18.1, R21.2
unnamed: C24.2, R12.1
unnamed: C6.2, D2.2 (K), L1.1, U2.17 (SW_2), U2.18 (SW), U2.19 (PRE)
unnamed: D4.1 (K), Q1.1 (G), R9.1, R24.2
unnamed: D6.1 (K), Q2.1 (G), R8.2, R26.1
unnamed: C25.1, Q5.1 (B), R13.2, U6.4 (RT/CT)
unnamed: C27.1, Q5.2 (C), R13.1, R20.2, U6.8 (VREF)
unnamed: C24.1, Q5.3 (E)
unnamed: C21.2, Q6.1 (B), R20.1
unnamed: C22.1, Q6.3 (E), R7.1, U6.1 (COMP)
unnamed: R15.2, U3.4
unnamed: R6.1, R16.2, U3.3
unnamed: R19.1, U3.1
unnamed: D3.1 (A), D3.3 (A), Q2.2 (D), T2.2 (AB)
unnamed: D5.1 (A), D5.3 (A), T2.4 (SB)
unnamed: C15.2, U1.4 (GNDI), U1.5 (DISABLE), U1.8 (SLDON)
unnamed: C15.1, R5.2, U1.3 (VDDI)
unnamed: C6.1, U2.20 (BST)
unnamed: C3.1, R1.1, U2.6 (COMP)
unnamed: R2.2, R3.1, U2.7 (FB)
unnamed: D2.1 (A), D2.3 (A), U2.15 (IS_2), U2.16 (IS)
unnamed: C4.1, U2.9 (RAMP)
unnamed: R4.1, U2.8 (RT)
unnamed: C1.1, U2.11 (SS)
unnamed: C2.1, U2.1 (VCC)
unnamed: R17.2, R21.1, U3.2, U5.1 (K), Z1.1 (K)
unnamed: C18.2, R22.2, R23.1, U5.2 (REF)
unnamed: C22.2, R7.2, R16.1, U6.2 (FB)
unnamed: C26.1, R12.2, R14.2, R15.1, U6.3 (ISENSE)
OUTGND: C28.2 (-), C29.2, C30.2, C31.2, C32.1, C33.1, J2.2, R23.2, T2.3 (SA), U5.3 (A), Z1.2 (A)
VIN: C9.1, C11.1, C12.1, C20.2, C23.2, C44.1, C45.1, C46.1, D3.2 (K), J1.1, Q1.2 (D), U2.3 (VIN_2), U2.4 (VIN)
Vo: C28.1 (+), C29.1, C30.1, C31.1, C32.2, C33.2, D5.2 (K), J2.1, R17.1, R19.2, R22.1

Notes on the sheet:
Isolated Supply 12-12
Two-Switch Flyback Converter
Two-Switch Flyback Controller
36-72V to 12V Buck
Two-channel Gate Driver
Input Filter

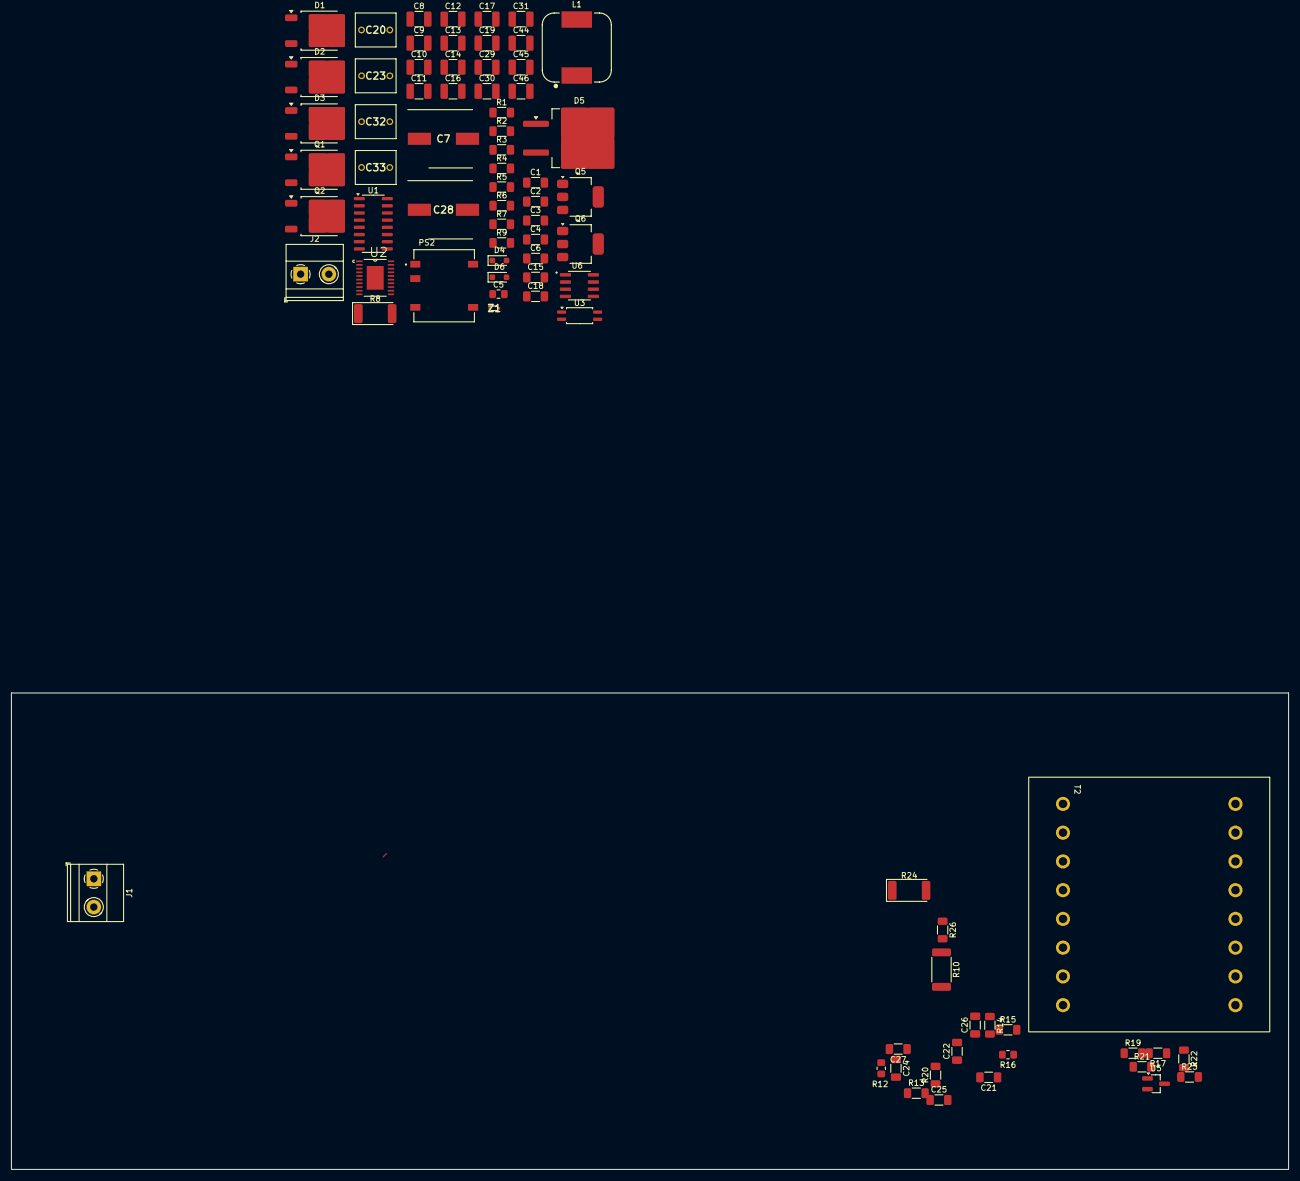
[picture p28: board ele713_ozdisan.kicad_pcb from above]

Board: 2 copper layers, 225.7 x 84.2 mm, 80 parts (0 on the bottom side), 42 nets.
