eliftplgl/ELE713-Two-Switch-Flyback/PCB/ele713/ele713.kicad_pcb

## KiCad design PCB/ele713/ele713.kicad_pcb (2024-12-17)

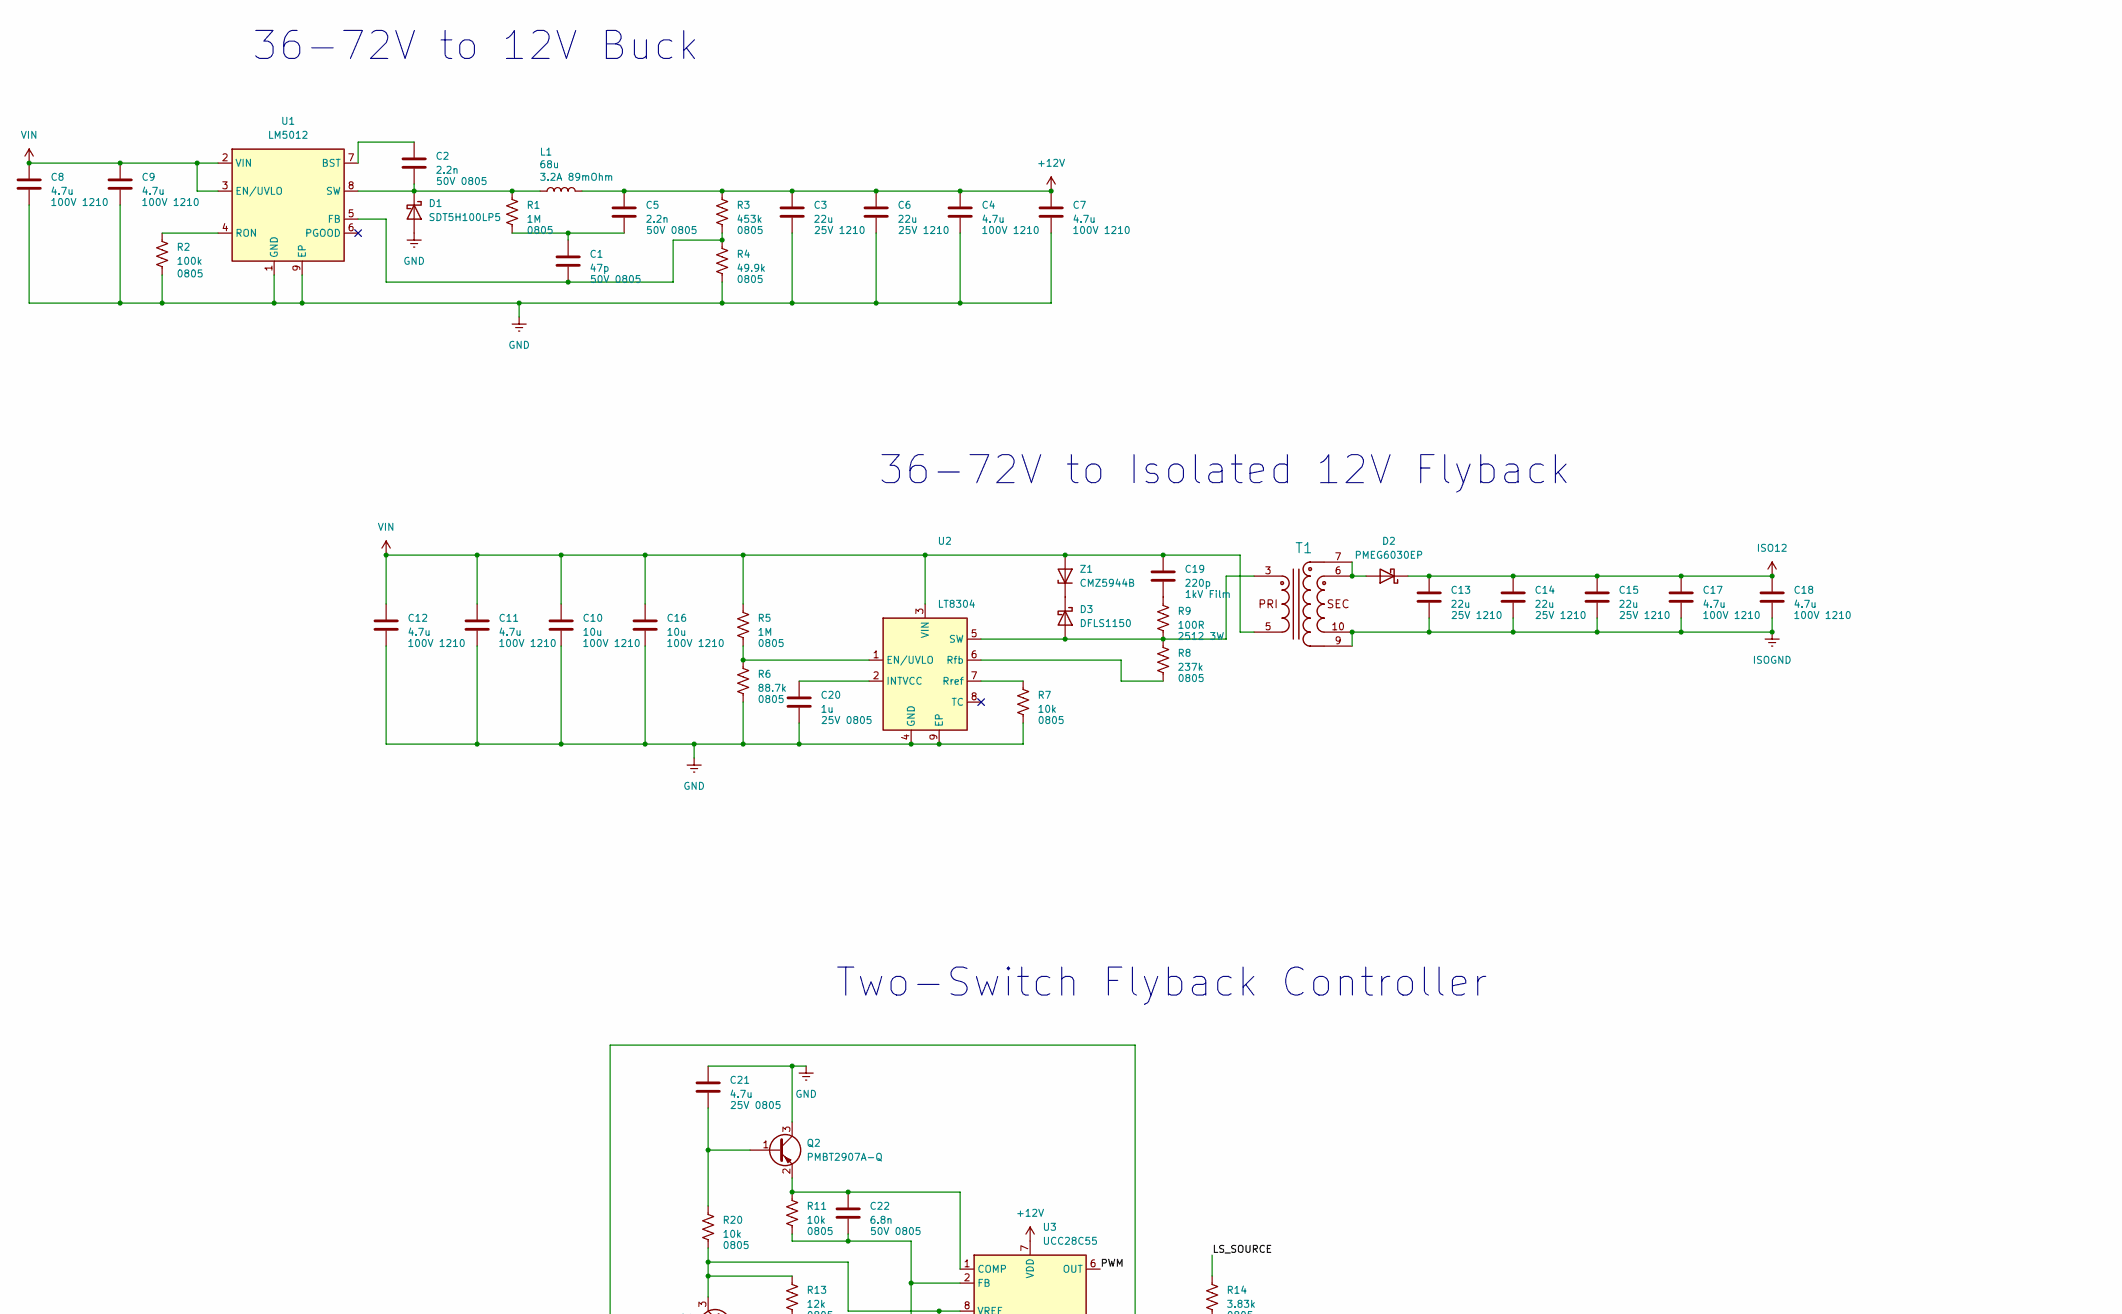
[picture p29: schematic ele713.kicad_sch, part in row 1, column 1]

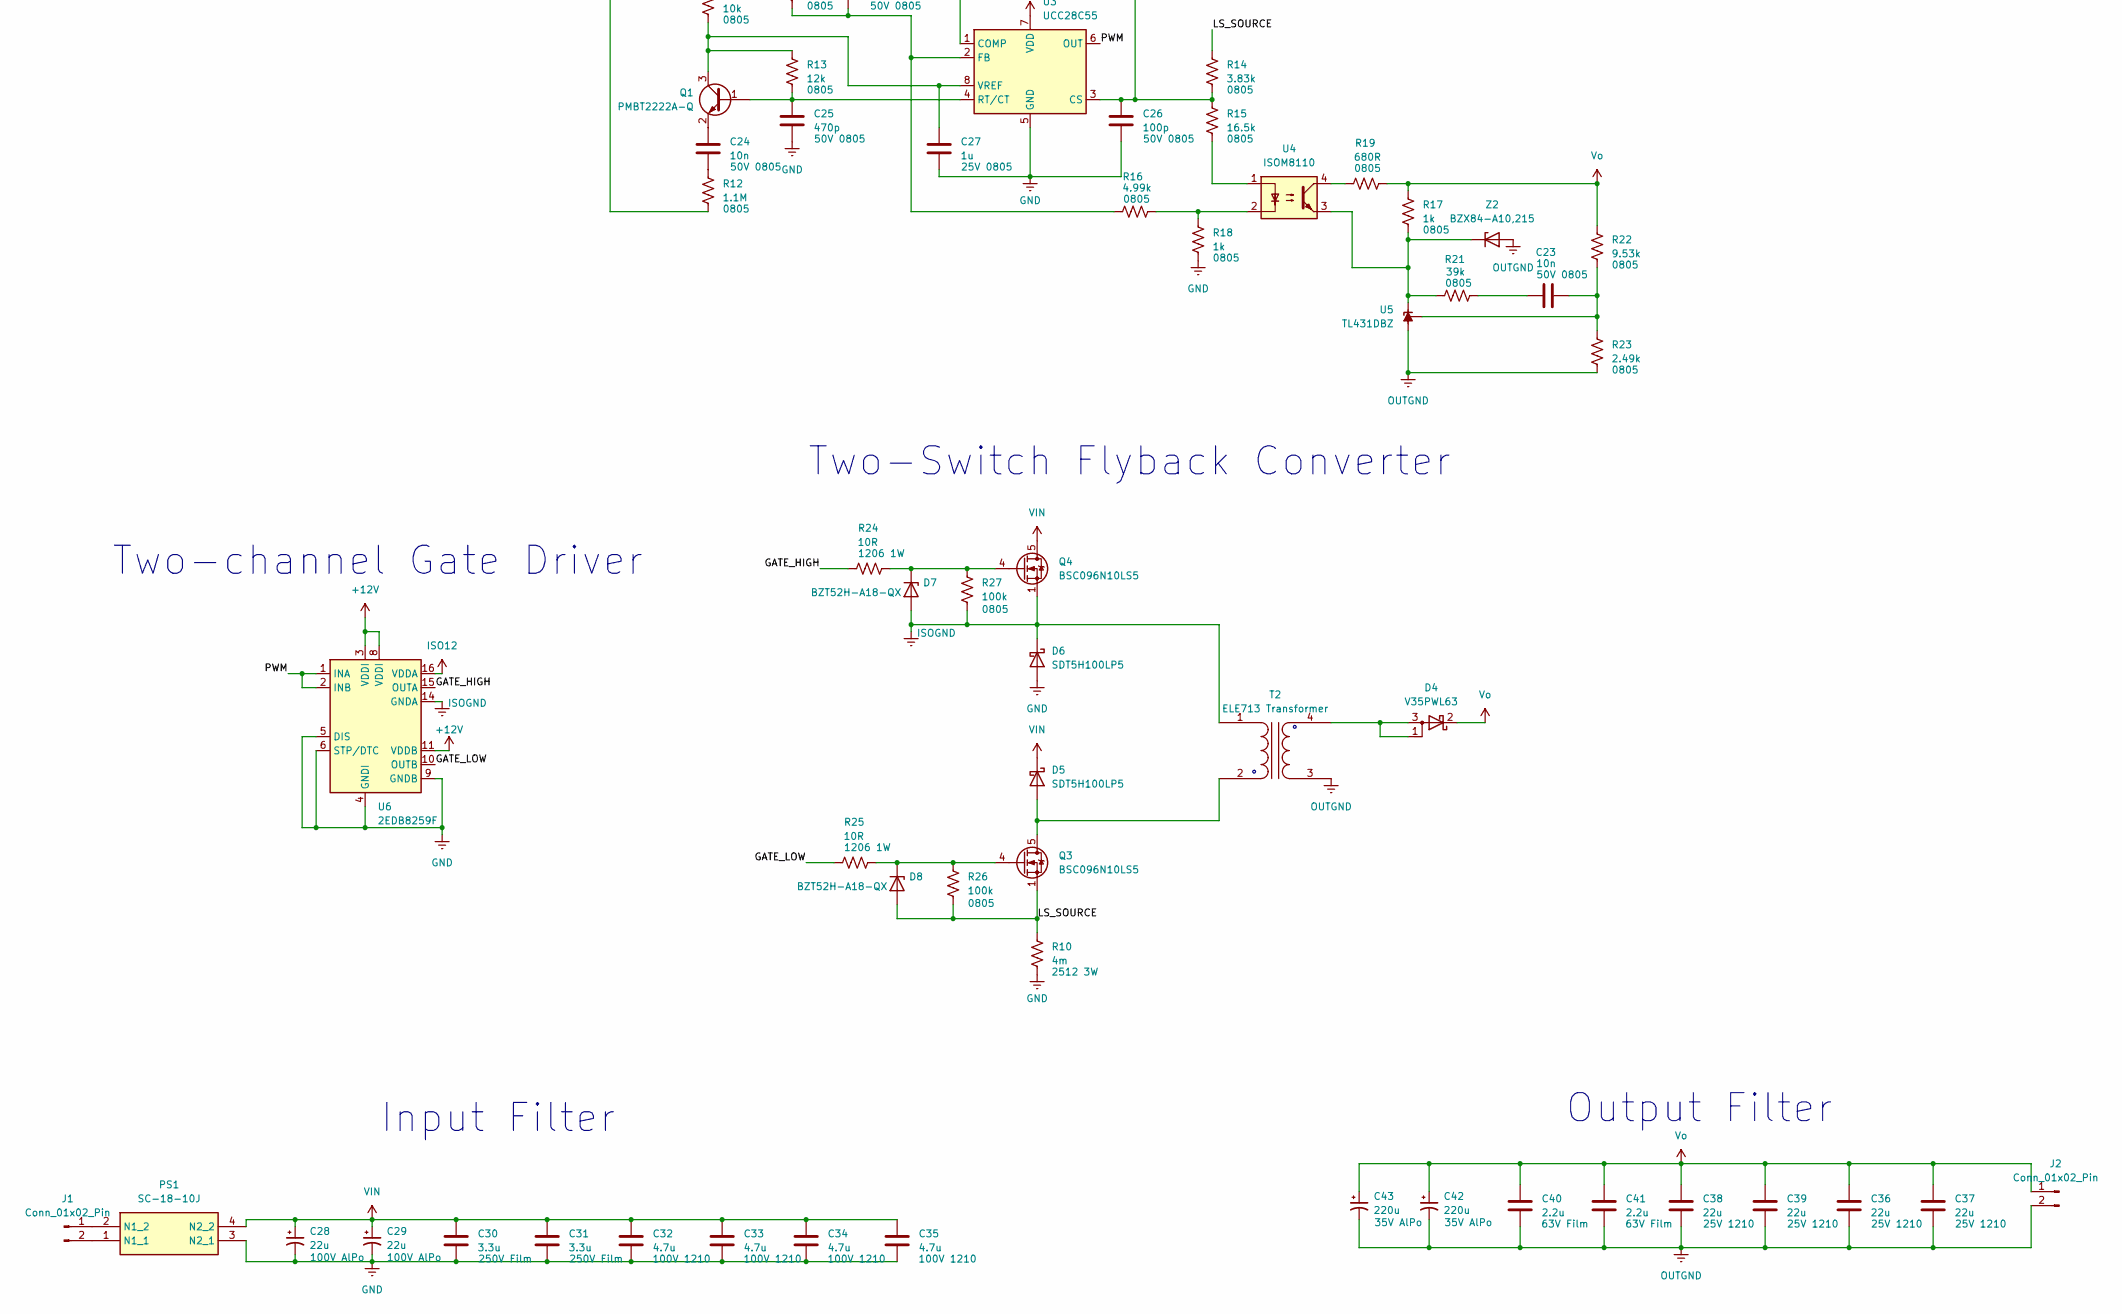
[picture p30: schematic ele713.kicad_sch, part in row 2, column 1]

Parts:
C1: 47p; C_0805_2012Metric_Pad1.18x1.45mm_HandSolder
C2, C5: 2.2n; C_0805_2012Metric_Pad1.18x1.45mm_HandSolder
C3, C6, C13, C14, C15, C36, C37, C38, C39: 22u; C_1210_3225Metric_Pad1.33x2.70mm_HandSolder
C4, C7, C8, C9, C11, C12, C17, C18, C32, C33, C34, C35: 4.7u; C_1210_3225Metric_Pad1.33x2.70mm_HandSolder
C10, C16: 10u; C_1210_3225Metric_Pad1.33x2.70mm_HandSolder
C19: 220p; R76QD0220SE00J
C20, C27: 1u; C_0805_2012Metric_Pad1.18x1.45mm_HandSolder
C21: 4.7u; C_0805_2012Metric_Pad1.18x1.45mm_HandSolder
C22: 6.8n; C_0805_2012Metric_Pad1.18x1.45mm_HandSolder
C23, C24: 10n; C_0805_2012Metric_Pad1.18x1.45mm_HandSolder
C25: 470p; C_0805_2012Metric_Pad1.18x1.45mm_HandSolder
C26: 100p; C_0805_2012Metric_Pad1.18x1.45mm_HandSolder
C28, C29: 22u; CP_Radial_D10.0mm_P5.00mm
C30, C31: 3.3u; R46KN410050N1K
C40, C41: 2.2u; F861KM473M310A
C42, C43: 220u; CAPAE830X1250N
D1, D5, D6: SDT5H100LP5; D_PowerDI-5
D2: PMEG6030EP; D_SOD-128
D3: DFLS1150; D_PowerDI-123
D4: V35PWL63; TO-252-2
D7, D8: BZT52H-A18-QX; D_SOD-123F
J1, J2: Conn_01x02_Pin; TerminalBlock_RND_205-00067_1x02_P7.50mm_Horizontal
L1: 68u; L_Coilcraft_MSS1210-XXX
PS1: SC-18-10J; SC1810J; Manufacturer_Part_Number SC-18-10J; Mouser Part Number 80-SC-18-10J
Q1: PMBT2222A-Q; SOT-23_Handsoldering
Q2: PMBT2907A-Q; SOT-23_Handsoldering
Q3, Q4: BSC096N10LS5; TDSON-8-1
R1, R5: 1M; R_0805_2012Metric_Pad1.20x1.40mm_HandSolder
R2, R26, R27: 100k; R_0805_2012Metric_Pad1.20x1.40mm_HandSolder
R3: 453k; R_0805_2012Metric_Pad1.20x1.40mm_HandSolder
R4: 49.9k; R_0805_2012Metric_Pad1.20x1.40mm_HandSolder
R6: 88.7k; R_0805_2012Metric_Pad1.20x1.40mm_HandSolder
R7, R11, R20: 10k; R_0805_2012Metric_Pad1.20x1.40mm_HandSolder
R8: 237k; R_0805_2012Metric_Pad1.20x1.40mm_HandSolder
R9: 100R; R_2512_6332Metric_Pad1.40x3.35mm_HandSolder
R10: 4m; R_2512_6332Metric_Pad1.40x3.35mm_HandSolder
R12: 1.1M; R_0805_2012Metric_Pad1.20x1.40mm_HandSolder
R13: 12k; R_0805_2012Metric_Pad1.20x1.40mm_HandSolder
R14: 3.83k; R_0805_2012Metric_Pad1.20x1.40mm_HandSolder
R15: 16.5k; R_0805_2012Metric_Pad1.20x1.40mm_HandSolder
R16: 4.99k; R_0805_2012Metric_Pad1.20x1.40mm_HandSolder
R17, R18: 1k; R_0805_2012Metric_Pad1.20x1.40mm_HandSolder
R19: 680R; R_0805_2012Metric_Pad1.20x1.40mm_HandSolder
R21: 39k; R_0805_2012Metric_Pad1.20x1.40mm_HandSolder
R22: 9.53k; R_0805_2012Metric_Pad1.20x1.40mm_HandSolder
R23: 2.49k; R_0805_2012Metric_Pad1.20x1.40mm_HandSolder
R24, R25: 10R; D_1206_3216Metric_Pad1.42x1.75mm_HandSolder
T1: Vi = 36-72V, Vo = 12V / 1.25A; WE-FLYLT_EP13_L13.46W17.75H12.70; Input Voltage 36-72VDC; Output Voltage 1 12V; Manufacturer Part Number 750315126
T2: ELE713 Transformer; ETD39_coilformer
U1: LM5012; HSOP-8-1EP_3.9x4.9mm_P1.27mm_EP2.41x3.1mm_ThermalVias
U2: LT8304; SOIC-8-1EP_3.9x4.9mm_P1.27mm_EP2.29x3mm
U3: UCC28C55; VSSOP-8_3x3mm_P0.65mm
U4: ISOM8110; SOIC-4_4.55x3.7mm_P2.54mm
U5: TL431DBZ; SOT-23
U6: 2EDB8259F; SOIC-16_3.9x9.9mm_P1.27mm
Z1: CMZ5944B; D_SMA_Handsoldering
Z2: BZX84-A10,215; SOT-23_Handsoldering

Connections:
+12V: C3.1, C4.1, C5.1, C6.1, C7.1, L1.2, R3.1, U3.7 (VDD), U6.3 (VDDI), U6.8 (VDDI), U6.11 (VDDB)
/GATE_HIGH: R24.1, U6.15 (OUTA)
/GATE_LOW: R25.1, U6.10 (OUTB)
/LS_SOURCE: D8.2 (A), Q3.1 (S), Q3.2 (S), Q3.3 (S), R10.1, R14.1, R26.2
/PWM: U3.6 (OUT), U6.1 (INA), U6.2 (INB)
GND: C3.2, C4.2, C6.2, C7.2, C8.2, C9.2, C10.2, C11.2, C12.2, C16.2, C20.2, C21.1, C25.2, C26.2, C27.2, C28.2, C29.2, C30.2, C31.2, C32.2, C33.2, C34.2, C35.2, D1.2 (A), D6.2 (A), PS1.3 (N2_1), Q2.3 (C), R2.2, R4.2, R6.2, R7.2, R10.2, R18.2, U1.1 (GND), U1.9 (EP), U2.4 (GND), U2.9 (EP), U3.5 (GND), U6.4 (GNDI), U6.5 (DIS), U6.6 (STP/DTC), U6.9 (GNDB)
ISO12: C13.1, C14.1, C15.1, C17.1, C18.1, D2.1 (K), U6.16 (VDDA)
ISOGND: C13.2, C14.2, C15.2, C17.2, C18.2, D6.1 (K), D7.2 (A), Q4.1 (S), Q4.2 (S), Q4.3 (S), R27.2, T1.9, T1.10, T2.1 (AA), U6.14 (GNDA)
unnamed: C1.1, C5.2, R1.2
unnamed: C19.2, R9.1
unnamed: C23.1, R21.2
unnamed: C24.2, R12.1
unnamed: C2.2, D1.1 (K), L1.1, R1.1, U1.8 (SW)
unnamed: D2.2 (A), T1.6, T1.7
unnamed: D3.2 (A), R8.1, R9.2, T1.3, U2.5 (SW)
unnamed: D3.1 (K), Z1.1 (K)
unnamed: D5.2 (A), Q3.5 (D), T2.2 (AB)
unnamed: D7.1 (K), Q4.4 (G), R24.2, R27.1
unnamed: D8.1 (K), Q3.4 (G), R25.2, R26.1
unnamed: J1.1, PS1.2 (N1_2)
unnamed: J1.2, PS1.1 (N1_1)
unnamed: C25.1, Q1.1 (B), R13.2, U3.4 (RT/CT)
unnamed: C27.1, Q1.3 (C), R13.1, R20.2, U3.8 (VREF)
unnamed: C24.1, Q1.2 (E)
unnamed: C21.2, Q2.1 (B), R20.1
unnamed: C22.1, Q2.2 (E), R11.1, U3.1 (COMP)
unnamed: R15.2, U4.1
unnamed: R16.2, R18.1, U4.2
unnamed: R19.1, U4.4
unnamed: D4.1 (A), D4.3 (A), T2.4 (SB)
unnamed: C2.1, U1.7 (BST)
unnamed: C1.2, R3.2, R4.1, U1.5 (FB)
unnamed: R2.1, U1.4 (RON)
unnamed: R5.2, R6.1, U2.1 (EN/UVLO)
unnamed: C20.1, U2.2 (INTVCC)
unnamed: R8.2, U2.6 (Rfb)
unnamed: R7.1, U2.7 (Rref)
unnamed: C26.1, R12.2, R14.2, R15.1, U3.3 (CS)
unnamed: C22.2, R11.2, R16.1, U3.2 (FB)
unnamed: R17.2, R21.1, U4.3, U5.1 (K), Z2.3 (K)
unnamed: C23.2, R22.2, R23.1, U5.2 (REF)
OUTGND: C36.2, C37.2, C38.2, C39.2, C40.2, C41.2, C42.2, C43.2, J2.2, R23.2, T2.3 (SA), U5.3 (A), Z2.1 (A)
VIN: C8.1, C9.1, C10.1, C11.1, C12.1, C16.1, C19.1, C28.1, C29.1, C30.1, C31.1, C32.1, C33.1, C34.1, C35.1, D5.1 (K), PS1.4 (N2_2), Q4.5 (D), R5.1, T1.5, U1.2 (VIN), U1.3 (EN/UVLO), U2.3 (VIN), Z1.2 (A)
Vo: C36.1, C37.1, C38.1, C39.1, C40.1, C41.1, C42.1, C43.1, D4.2 (K), J2.1, R17.1, R19.2, R22.1

Notes on the sheet:
Two-Switch Flyback Converter
Output Filter
36-72V to Isolated 12V Flyback
Two-Switch Flyback Controller
36-72V to 12V Buck
Two-channel Gate Driver
Input Filter

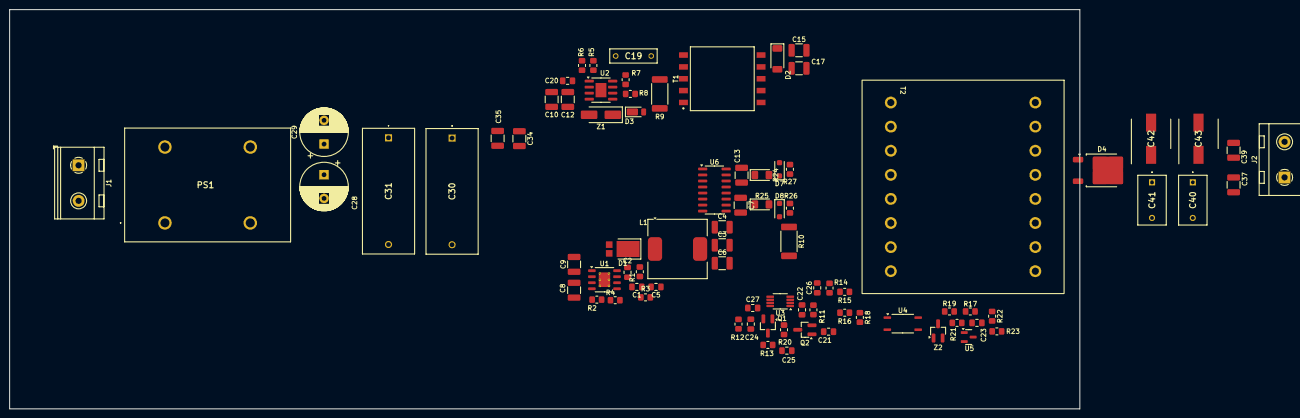
[picture p31: board ele713.kicad_pcb from above]

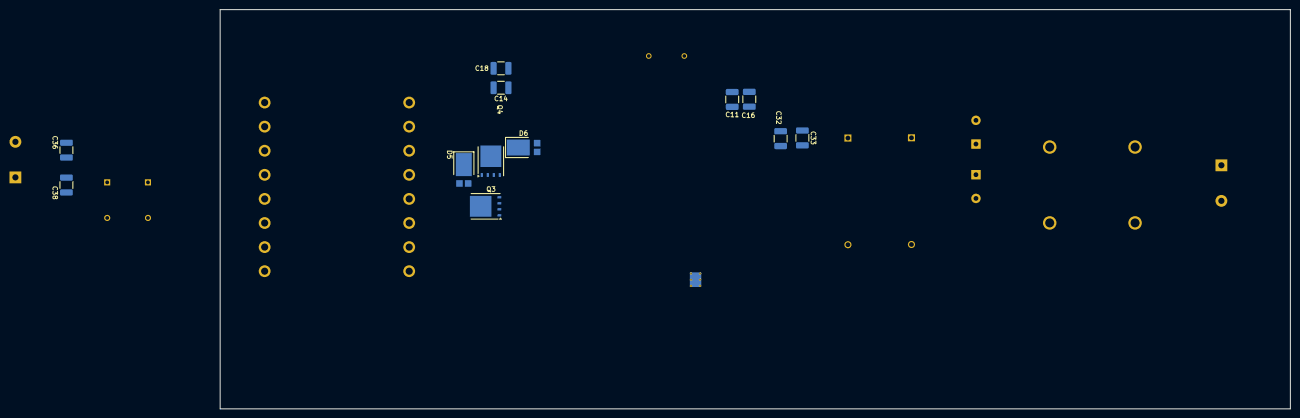
[picture p32: board ele713.kicad_pcb from below]

Board: 2 copper layers, 225.7 x 84.2 mm, 96 parts (12 on the bottom side), 44 nets.
