eliftplgl/ELE713-Two-Switch-Flyback/(commit log)

2024-11-25 Flyback design tool V1
    [Flyback Design Tool.xlsx]
2024-11-25 Component List and Simulation Files were added
    [componentList.xlsx]
2024-11-30 Controller design parameters
    [Flyback Design Tool.xlsx]
2024-12-01 Component List almost done, input and output filters left
    [componentList.xlsx]
2024-12-02 Final component list with mostly exact component counts
    [componentList.xlsx]
2024-12-10 Controller schematics done, though some lib files only exist on lab computer
    [ele713.kicad_pcb, ele713.kicad_sch]
2024-12-11 libraries added, schematic fully completed except terminals
    [A768KS227M1VLAE024.stp, DFG0004A.stp, F861KM473M310A.stp, PowerDI5.stp, R46KN410050N1K.stp, R76QD0220SE00J.stp, SC-18-10J.stp, WE-FLYLT_EP13_L13.46W17.75H12.70.STEP]
2024-12-17 pcb v1 is uploaded
    [ele713.kicad_pcb]
2024-12-23 digikey -> ozdisan half done. magenta ones are OK, green ones need work
    [componentList.xlsx, componentList_digikey.xlsx]
2024-12-24 almost done digikey -> ozdisan, orange ones are unfinished. red ones are critical
    [componentList.xlsx]
2024-12-24 only optocoupler missing
    [componentList.xlsx]
2024-12-31 ozdisan version schematic finished
    [A768KS227M1VLAE024.stp, BZT585B10T-7.stp, DFG0004A.stp, F861KM473M310A.stp, LM5576MHX_NOPB.step, PowerDI5.stp, R1S-1212-R.step, R46KN410050N1K.stp]
2025-01-03 PCB v1 ve v2 çizildi
    Çok sancılı bir süreç, ilk PCB yi çizmek zormuş yıprandım. Neyse, v1 ve v2 çizildi. V2 basılacak olan şimdilik.
    [ele713_ozdisan.kicad_sch, ele713_ozdisan_v1.kicad_pcb, ele713_ozdisan_v2.kicad_pcb]
